josefe17/ClassDAmplifier/schematics-PCB/power_rectifier_board_510/gerbers/IMPORTANT_NOTE.txt

Please, make the board with only solder mask on copper side (gbs file) and silk only on top side (gto file).

Thanks
