josefe17/ClassDAmplifier/schematics-PCB/IRS2092_board_H61M/IRS2092_board_H61M.html

# C:/Users/josefe/Dropbox/etsit/TFG/PCB/IRS2092_board_H61M/IRS2092_board_H61M.sch

19/03/2018 21:16:16

Eeschema 4.0.7

Component Count:94

Ref | Qnty | Value | Part | Datasheet | Description | Vendor
C1, C4, C8, C11, C15, C17 | 6 | 100n | device:C | | Unpolarized capacitor
C2, C3, C9, C10, C14, C20, C26 | 7 | 10u | device:CP | | Polarised capacitor
C5, C6 | 2 | 2n2 | device:C | | Unpolarized capacitor
C7 | 1 | 1n | device:C | | Unpolarized capacitor
C12, C18 | 2 | 1u | device:CP | | Polarised capacitor
C13 | 1 | 22u | device:CP | | Polarised capacitor
C16 | 1 | 47u | device:CP | | Polarised capacitor
C19, C22, C24, C25, C27, C29 | 6 | 100n | device:C | | Unpolarized capacitor
C21, C23 | 2 | 680u | device:CP | | Polarised capacitor
C28 | 1 | 680n | device:C | | Unpolarized capacitor
C30 | 1 | C | device:C | | Unpolarized capacitor
D1, D7, D8 | 3 | 1N4007 | diode:1N4007 | | 50V 1A General Purpose Rectifier Diode, DO-41
D2, D5, D6 | 3 | 18V | device:D_Zener | | Zener Diode
D3 | 1 | MUR120 | ir_audio_mosfets:MUR120
D4 | 1 | BAV21 | diode:BAV21 | | 100V 0.15A standard switching diode, DO-35
J1 | 1 | Vb | conn:Screw_Terminal_01x02 | | Generic screw terminal, single row, 01x02
J2 | 1 | Audio input | IRS2092_board_H61M-cache:CONN_01X02
J3 | 1 | Protection | IRS2092_board_H61M-cache:CONN_01X02
J4 | 1 | Shutdown | IRS2092_board_H61M-cache:CONN_01X02
J5 | 1 | Driver_ON | IRS2092_board_H61M-cache:CONN_01X02
J6 | 1 | Input_test | conn:TEST_1P | | point
J7 | 1 | Output_test | conn:TEST_1P | | point
J8 | 1 | Output | IRS2092_board_H61M-cache:Screw_Terminal_1x02
J9 | 1 | -Vb | conn:Screw_Terminal_01x02 | | Generic screw terminal, single row, 01x02
J10 | 1 | CSD_test | conn:TEST_1P | | point
J11 | 1 | Vss_test | conn:TEST_1P | | point
J12 | 1 | Vaa_test | conn:TEST_1P | | point
J13 | 1 | LO_test | conn:TEST_1P | | point
J14 | 1 | Vcc_test | conn:TEST_1P | | point
J15 | 1 | Vs_test | conn:TEST_1P | | point
L1 | 1 | 47uH | pspice:INDUCTOR
Q1 | 1 | BS250 | device:Q_PMOS_DGS | | Transistor P-MOSFET with substrate diode (general)
Q2, Q3 | 2 | IRFB4020 | ir_audio_mosfets:IRFB4020 | | 200V Vds,18A Id, Single N-Channel Digital Audio HEXFET Power MOSFET, TO-220AB
Q4 | 1 | TIP122 | transistors:TIP122 | | 5A Ic, 60V Vce, Silicon Darlington Power Transistor NPN, TO-220
R1, R10, R14 | 3 | 10R | device:R | | Resistor
R2 | 1 | 330R | device:R | | Resistor
R3 | 1 | 2K | device:R | | Resistor
R4 | 1 | 165R | device:R | | Resistor
R5 | 1 | 2K2 | device:R | | Resistor
R6 | 1 | 3K01 | device:R | | Resistor
R7 | 1 | 6K98 | device:R | | Resistor
R8 | 1 | 1K | device:R | | Resistor
R9 | 1 | 5k11 | device:R | | Resistor
R11, R18 | 2 | 47K | device:R | | Resistor
R12 | 1 | 5K11 | device:R | | Resistor
R13, R23 | 2 | 1K8 | device:R | | Resistor
R15 | 1 | 27K | device:R | | Resistor
R16 | 1 | 4R7 | device:R | | Resistor
R17, R20, R24 | 3 | 10K | device:R | | Resistor
R19 | 1 | 8K06 | device:R | | Resistor
R21, R22 | 2 | 12R | device:R | | Resistor
R25 | 1 | 1R | device:R | | Resistor
R26 | 1 | 10R | device:R | | Resistor
R27 | 1 | 2K2 | device:R | | Resistor
R28 | 1 | R | device:R | | Resistor
RV1 | 1 | 1K | device:POT | | Potentiometer
U1, U4 | 2 | 4N35 | IRS2092_board_H61M-cache:4N35
U2 | 1 | 7905 | IRS2092_board_H61M-cache:7905
U3 | 1 | IRS2092 | ir:IRS2092 | | Protected Class D Audio Amplifier Half-Bridge Gate Driver, With PWM Modulator, Output Current 1.0/1.2A, +/-100V, PDIP-16/SOIC-16
U5 | 1 | 6N136 | IRS2092_board_H61M-rescue:6N136-RESCUE-IRS2092_board_H61M
U6 | 1 | 7805 | IRS2092_board_H61M-cache:7805
U7 | 1 | LM7812 | IRS2092_board_H61M-cache:LM7812
