josefe17/ClassDAmplifier/schematics-PCB/power_rectifier_board_510/power_rectifier_board_510.html

# C:/Users/josefe/Dropbox/etsit/TFG/PCB/power_rectifier_board_510/power_rectifier_board_510.sch

21/03/2018 16:50:49

Eeschema 4.0.7

Component Count:16

Ref | Qnty | Value | Part | Datasheet | Description | Vendor
C1, C2, C3 | 3 | CP | device:CP | | Polarised capacitor
C4 | 1 | CP | device:CP | | Polarised capacitor
C5 | 1 | CP | device:CP | | Polarised capacitor
D1 | 1 | D_Bridge_+A-A | device:D_Bridge_+A-A | | Diode bridge (pins: 1=+, 2=AC, 3=-, 4=AC)
F1 | 1 | Fuse | device:Fuse | | Fuse, generic
J1 | 1 | AC1 in | conn:Screw_Terminal_01x02 | | Generic screw terminal, single row, 01x02
J2 | 1 | AC2 in | conn:Screw_Terminal_01x02 | | Generic screw terminal, single row, 01x02
J3 | 1 | Transf. 1 | conn:Screw_Terminal_01x02 | | Generic screw terminal, single row, 01x02
J4 | 1 | Transf. 2 | conn:Screw_Terminal_01x02 | | Generic screw terminal, single row, 01x02
J5 | 1 | Transf. link | conn:Screw_Terminal_01x02 | | Generic screw terminal, single row, 01x02
J6 | 1 | Transf. out | conn:Screw_Terminal_01x02 | | Generic screw terminal, single row, 01x02
J7 | 1 | Serial link | conn:Screw_Terminal_01x02 | | Generic screw terminal, single row, 01x02
J8 | 1 | DC_A | conn:Screw_Terminal_01x02 | | Generic screw terminal, single row, 01x02
J9 | 1 | DC_B | conn:Screw_Terminal_01x02 | | Generic screw terminal, single row, 01x02
