josefe17/ClassDAmplifier/schematics-PCB/preamplifier_510/preamplifier_510.html

# C:/Users/josefe/Dropbox/etsit/TFG/PCB/preamplifier_510/preamplifier_510.sch

21/03/2018 16:49:08

Eeschema 4.0.7

Component Count:58

Ref | Qnty | Value | Part | Datasheet | Description | Vendor
C1, C8, C9 | 3 | 100u | device:CP | | Polarised capacitor
C3, C6 | 2 | 10u | device:CP_Small | | Polarised capacitor
C4, C7 | 2 | C | device:C | | Unpolarized capacitor
C10, C11, C12, C13 | 4 | 100n | device:C_Small | | Unpolarized capacitor
D1 | 1 | Power | device:LED | | LED generic
D2 | 1 | Parallel/Phase | device:LED | | LED generic
D3 | 1 | Active | device:LED | | LED generic
D4 | 1 | Protection | device:LED | | LED generic
D5 | 1 | -10 | device:LED | | LED generic
D6 | 1 | -5 | device:LED | | LED generic
D7 | 1 | 0 | device:LED | | LED generic
D8 | 1 | 3 | device:LED | | LED generic
D9 | 1 | 6 | device:LED | | LED generic
J1 | 1 | 5Vdc | conn:Conn_01x02 | | Generic connector, single row, 01x02
J2 | 1 | XLR3 | conn:XLR3 | | 3 pins
J4 | 1 | Output Active | conn:Conn_01x02 | | Generic connector, single row, 01x02
J5 | 1 | Protection | conn:Conn_01x02 | | Generic connector, single row, 01x02
J6 | 1 | -Vcc | conn:Conn_01x02 | | Generic connector, single row, 01x02
J7 | 1 | +Vcc | conn:Conn_01x02 | | Generic connector, single row, 01x02
J8 | 1 | Out_A(A)/Dir_B(B) | conn:Conn_01x02 | | Generic connector, single row, 01x02
J9 | 1 | Dir_B(A)/B_in(B) | conn:Conn_01x02 | | Generic connector, single row, 01x02
J10 | 1 | B_in(A)/Out_B(B) | conn:Conn_01x02 | | Generic connector, single row, 01x02
J11 | 1 | VU_level | conn:TEST_1P | | point
J12 | 1 | Preamp_out | conn:TEST_1P | | point
JP1 | 1 | FIXED-GAIN | device:Jumper_NC_Dual | | Dual Jumper, normally closed
JP2 | 1 | Out_A(A)/φ(B) | device:Jumper_NC_Dual | | Dual Jumper, normally closed
Q1 | 1 | BC547 | transistors:BC547 | | 45V Vce, 0.1A Ic, NPN, Small Signal Transistor, TO-92
R1, R2 | 2 | 220R | device:R | | Resistor
R3, R4, R6, R7, R15, R16 | 6 | 10K | device:R | | Resistor
R5 | 1 | 82R5 | device:R | | Resistor
R8 | 1 | 0R | device:R | | Resistor
R9 | 1 | 1K1 | device:R | | Resistor
R10 | 1 | 2K2 | device:R | | Resistor
R11 | 1 | R | device:R | | Resistor
R12 | 1 | 3K3 | device:R | | Resistor
R13 | 1 | 6K8 | device:R | | Resistor
R14 | 1 | Rled | device:R | | Resistor
R17 | 1 | Rf | device:R | | Resistor
RV1 | 1 | VOLUME | device:POT_Dual_Separate | | Dual Potentiometer, separate units
RV2 | 1 | 10K | device:POT | | Potentiometer
SW1 | 1 | Parallel/Phase | switches:SW_DPDT_x2 | | Switch, dual pole double throw, separate symbols
SW2 | 1 | +4/-10 | switches:SW_DPDT_x2 | | Switch, dual pole double throw, separate symbols
U1 | 1 | TL072 | linear:TL072 | | Dual Operational Amplifiers, DIP-8/SOIC-8/TSSOP-8/VSSOP-8
U2 | 1 | AN6884 | an6884:AN6884 | | AN6884 Audio meter VU scale
U3 | 1 | TL071 | linear:TL071 | | Operational Amplifier, DIP-8/TO-99-8
