josefe17/ClassDAmplifier/schematics-PCB/regulated_power_supply_510/regulated_power_supply_510.html

# C:/Users/josefe/Dropbox/etsit/TFG/PCB/regulated_power_supply_510/regulated_power_supply_510.sch

21/03/2018 16:51:49

Eeschema 4.0.7

Component Count:20

Ref | Qnty | Value | Part | Datasheet | Description | Vendor
C1, C4 | 2 | 100nF | device:C | | Unpolarized capacitor
C2 | 1 | 2200uf | device:CP | | Polarised capacitor
C3 | 1 | 10uF | device:CP | | Polarised capacitor
C5 | 1 | 1000uF | device:CP | | Polarised capacitor
D1 | 1 | VS-KBPC110 | device:D_Bridge_-A+A | | Diode bridge (pins: 1=-, 2=AC, 3=+, 4=AC)
D2, D3 | 2 | 1N4007 | device:D | | Diode
F1 | 1 | 200mA | device:Fuse | | Fuse, generic
J1 | 1 | AC in | conn:Screw_Terminal_01x02 | | Generic screw terminal, single row, 01x02
J2 | 1 | DC link | conn:Conn_01x02 | | Generic connector, single row, 01x02
J3 | 1 | DC1 | conn:Conn_01x02 | | Generic connector, single row, 01x02
J4 | 1 | DC2 | conn:Conn_01x02 | | Generic connector, single row, 01x02
J5 | 1 | DC3 | conn:Conn_01x02 | | Generic connector, single row, 01x02
J6 | 1 | GND | conn:Conn_01x02 | | Generic connector, single row, 01x02
J7 | 1 | unregulated DC | conn:Conn_01x02 | | Generic connector, single row, 01x02
R1 | 1 | 240R | device:R | | Resistor
RV1 | 1 | 2K | device:POT | | Potentiometer
U1 | 1 | LM317 | regul:LM317_3PinPackage | | 1A 35V Adjustable Linear Regulator, SOT-89/SOT-223/TO-220/TO-252/TO-263
U2 | 1 | LM337 | regul:LM337_TO220 | | Negative 1.5A 35V Adjustable Linear Regulator, TO-220
