josefe17/ClassDAmplifier/Block_diagrams/blocks_POWER.PNG

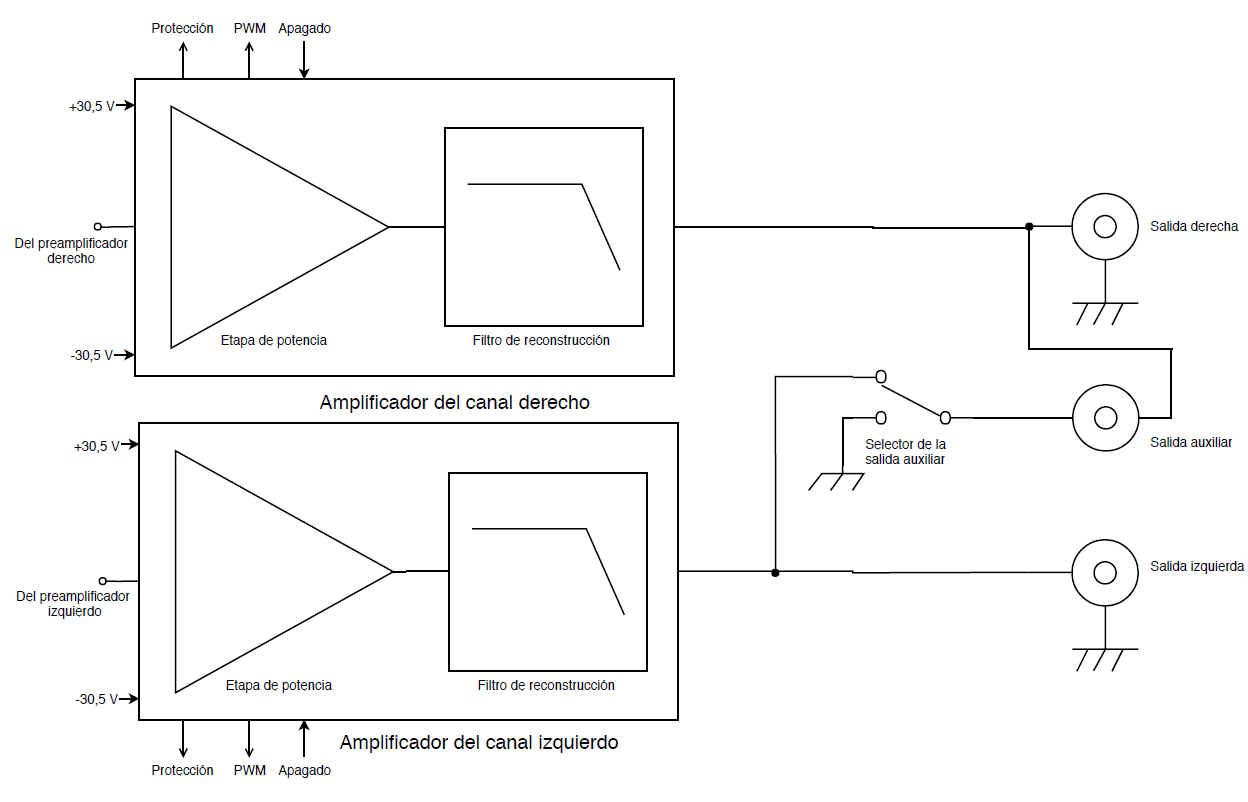
Block_diagrams/blocks_POWER.PNG
