josefe17/ClassDAmplifier/Block_diagrams/blocks_PREAMP.PNG

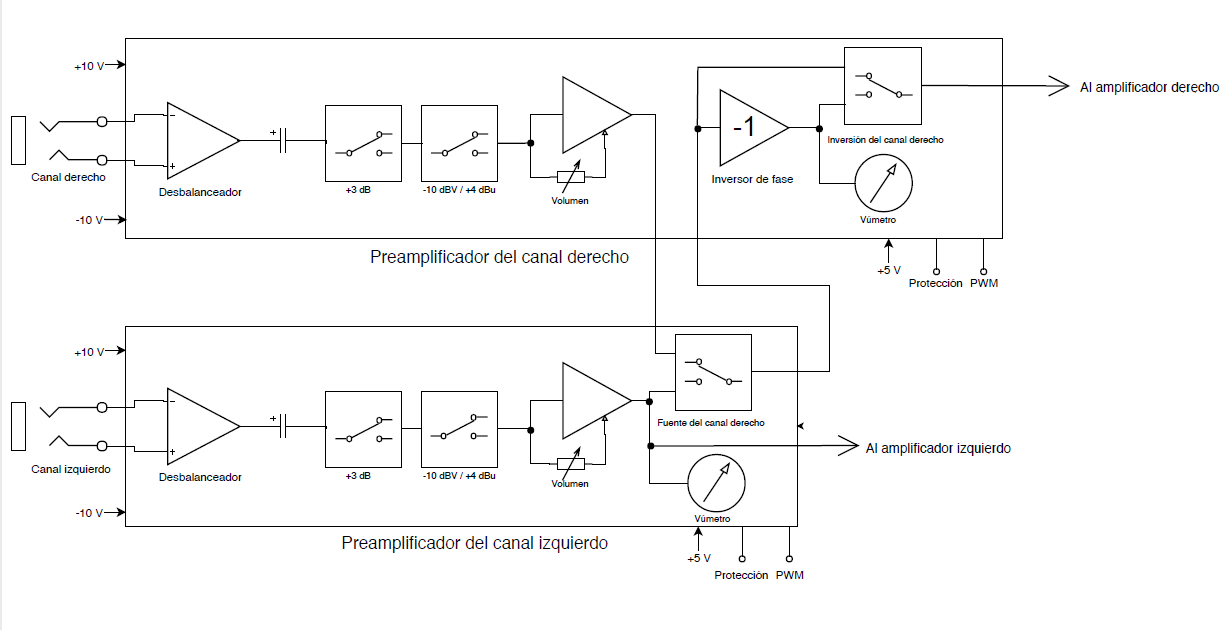
Block_diagrams/blocks_PREAMP.PNG
