josefe17/ClassDAmplifier/Block_diagrams/blocks_PSU.PNG

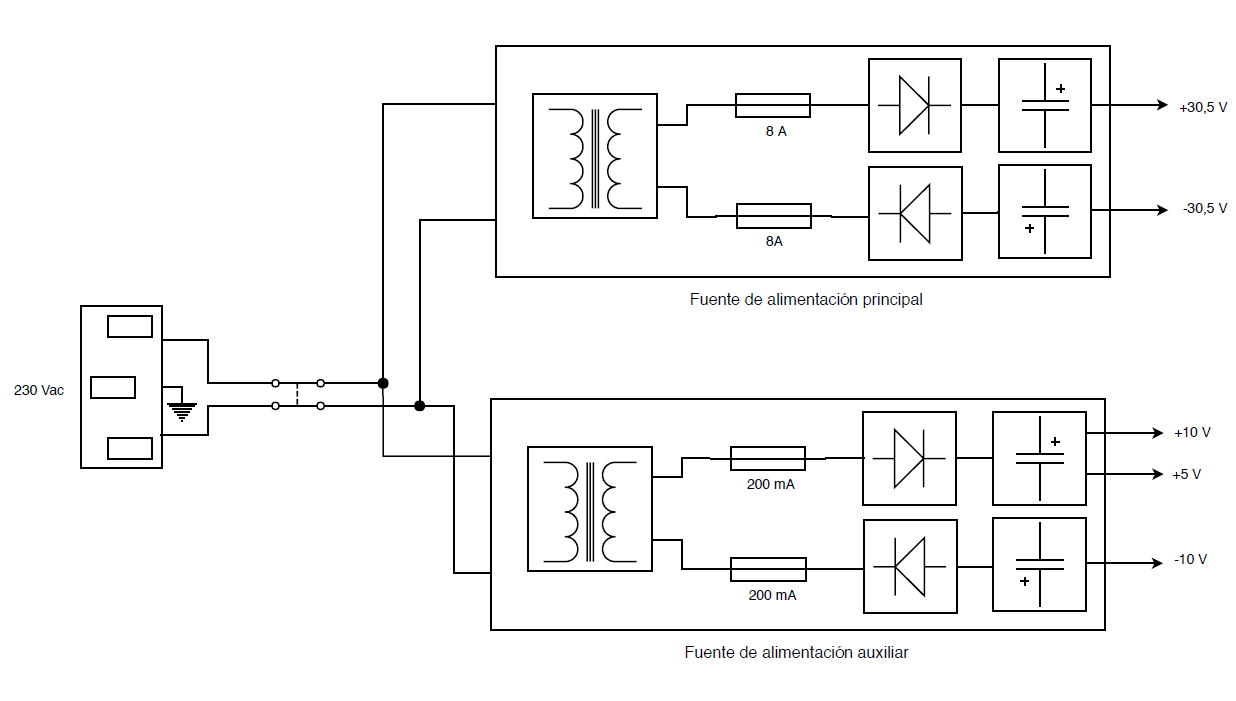
Block_diagrams/blocks_PSU.PNG
