josefe17/ClassDAmplifier/Block_diagrams/blocks_selector.PNG

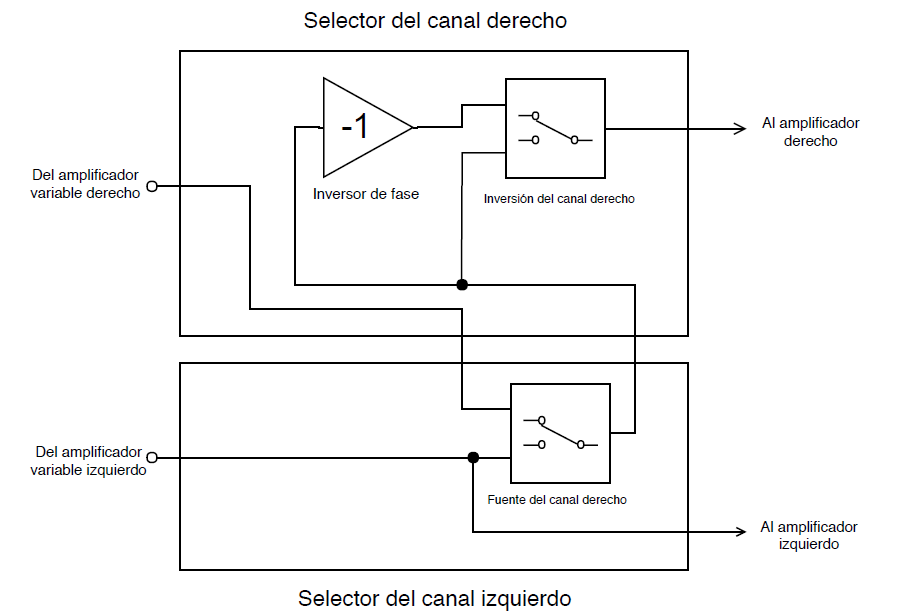
Block_diagrams/blocks_selector.PNG
