josefe17/ClassDAmplifier/Pictures/device_pic_3.JPG

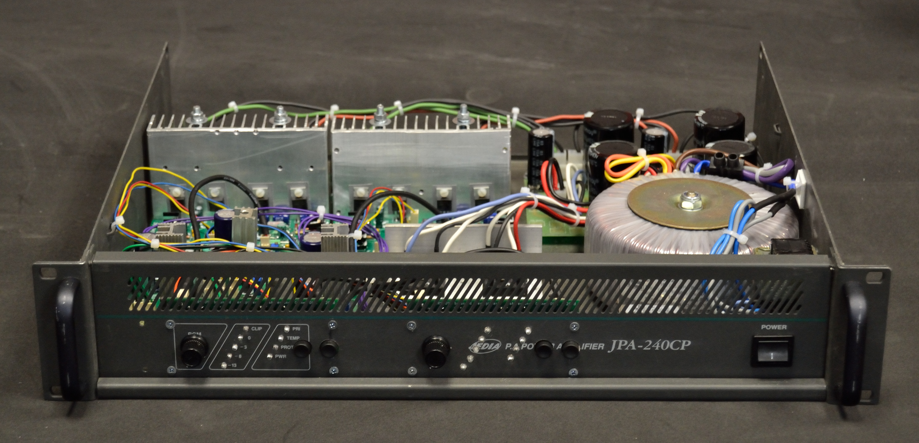
Pictures/device_pic_3.JPG
