josefe17/ClassDAmplifier/Pictures/front_pic_3.JPG

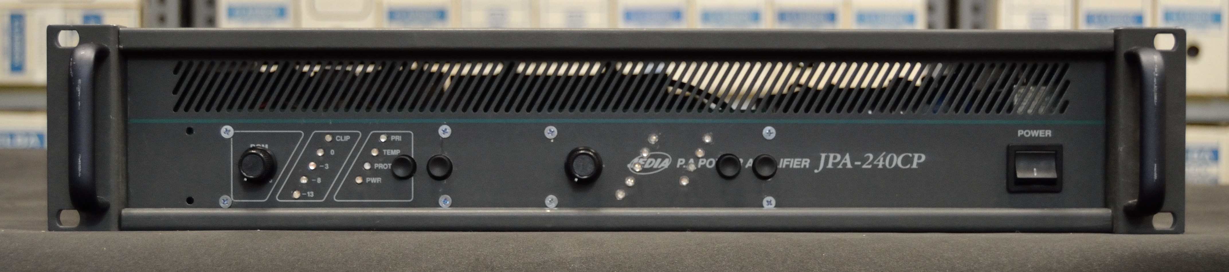
Pictures/front_pic_3.JPG
