josefe17/ClassDAmplifier/Pictures/proto_v0.jpg

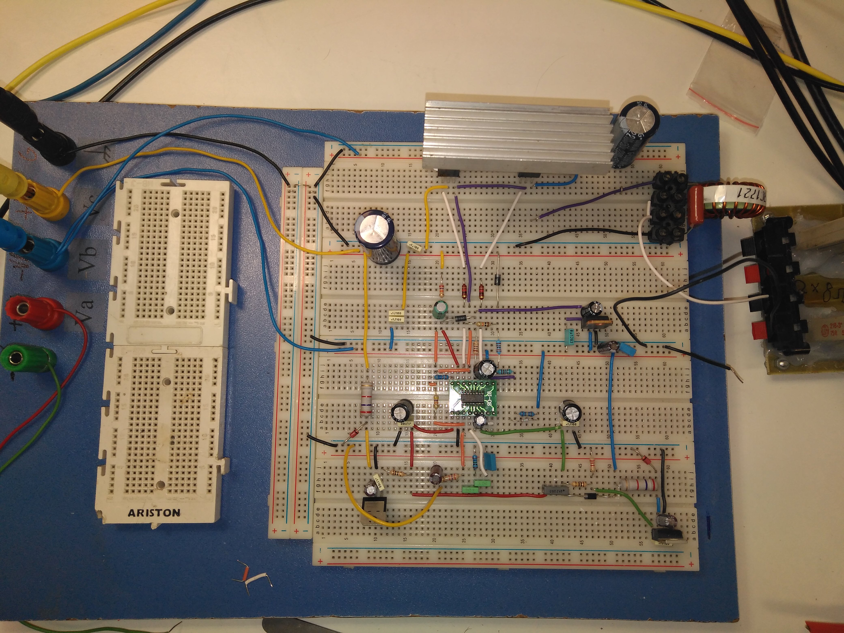
Pictures/proto_v0.jpg
