josefe17/ClassDAmplifier/Pictures/proto_v1.jpg

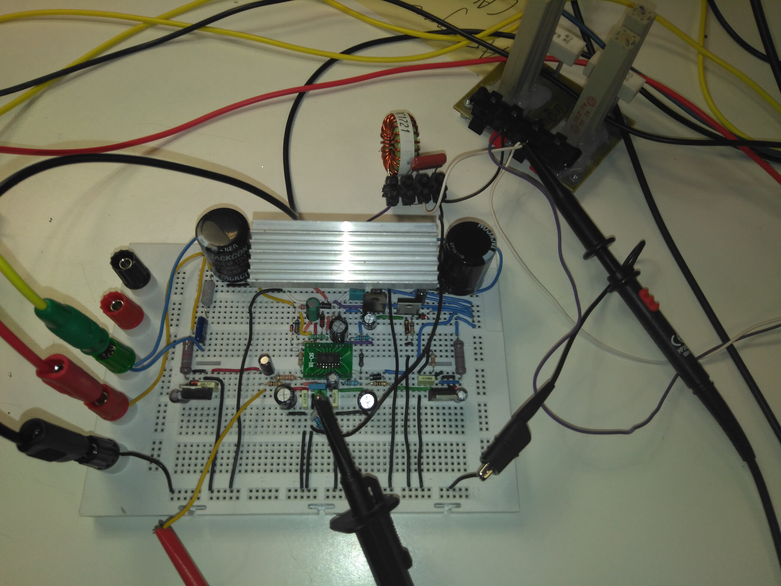
Pictures/proto_v1.jpg
