josefe17/ClassDAmplifier/Pictures/top_pic.JPG

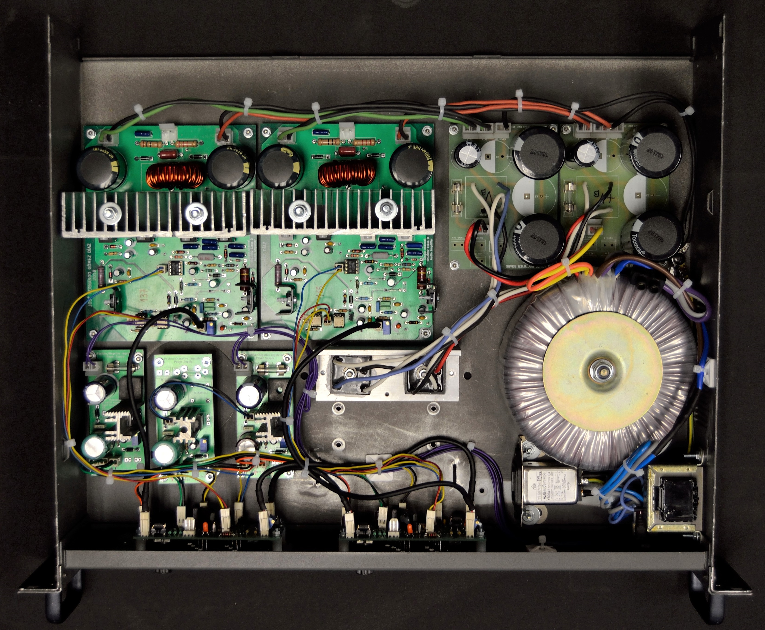
Pictures/top_pic.JPG
