josefe17/ClassDAmplifier/schematics-PCB/IRS2092_board_H61M/3d/IRS2092_board_H61M_v3_angled.png

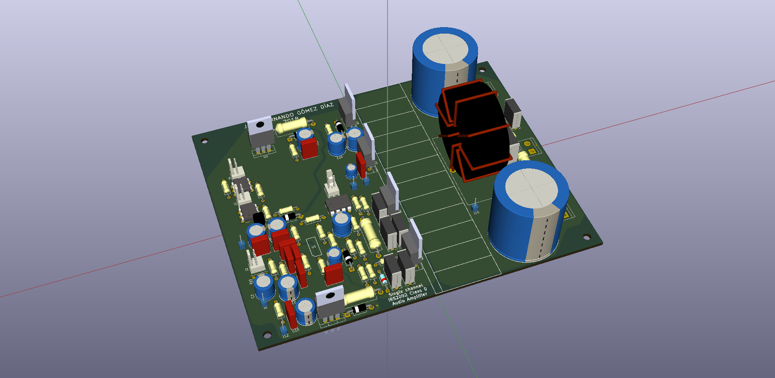
schematics-PCB/IRS2092_board_H61M/3d/IRS2092_board_H61M_v3_angled.png
