josefe17/ClassDAmplifier/schematics-PCB/IRS2092_board_H61M/IRS2092_board_H61M.png

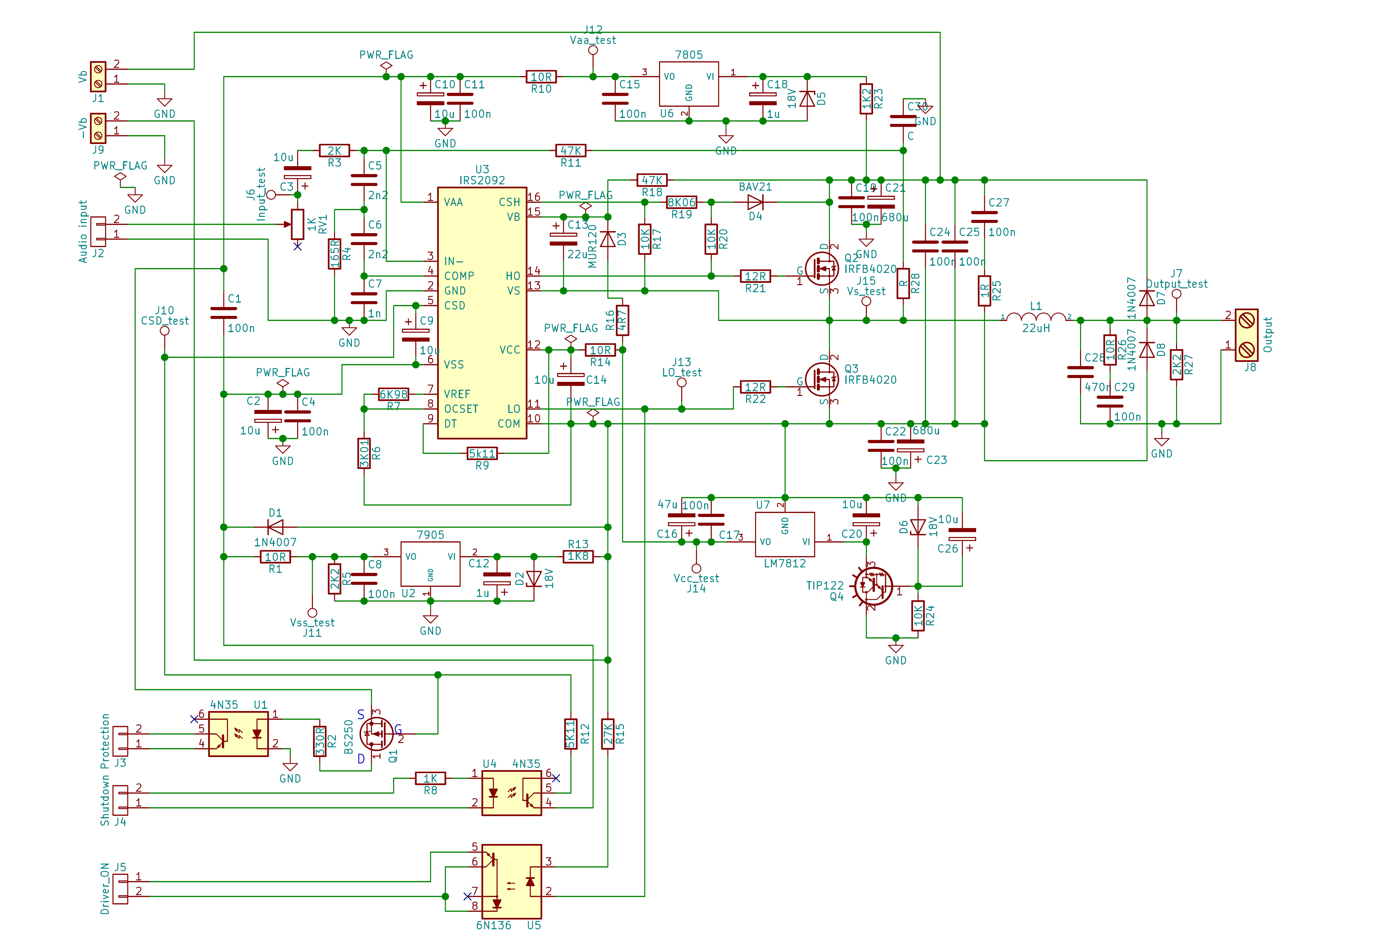
schematics-PCB/IRS2092_board_H61M/IRS2092_board_H61M.png
