josefe17/ClassDAmplifier/schematics-PCB/power_rectifier_board_510/3d/power_rectifier_board_510_naked.png

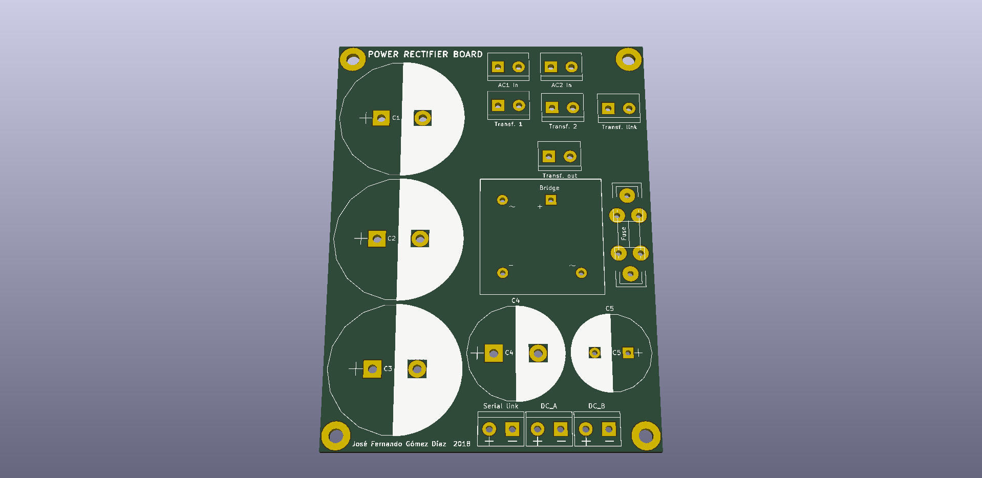
schematics-PCB/power_rectifier_board_510/3d/power_rectifier_board_510_naked.png
