josefe17/ClassDAmplifier/schematics-PCB/power_rectifier_board_510/power_rectifier_board_510.png

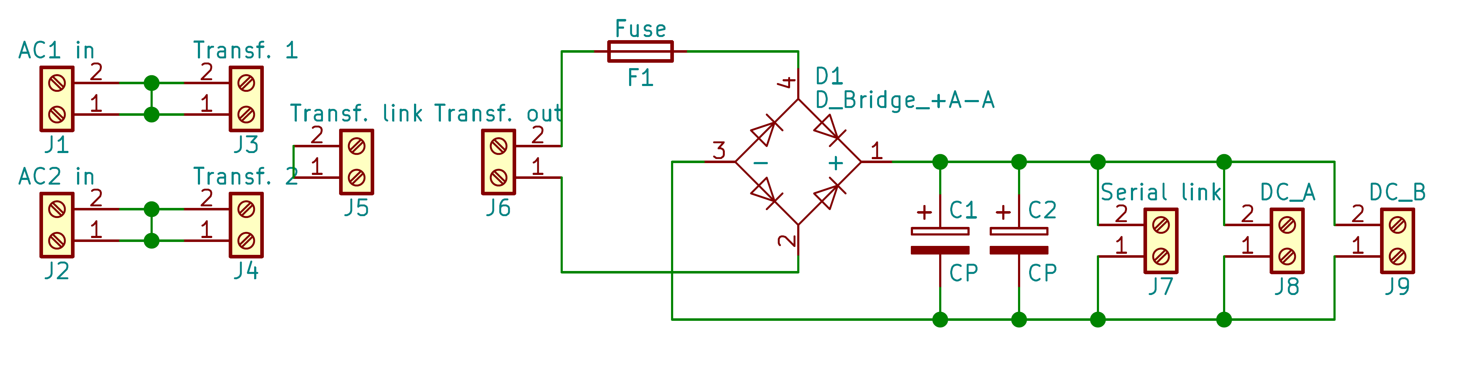
schematics-PCB/power_rectifier_board_510/power_rectifier_board_510.png
