josefe17/ClassDAmplifier/schematics-PCB/preamplifier_510/3d/preamplifier_510_back_naked.png

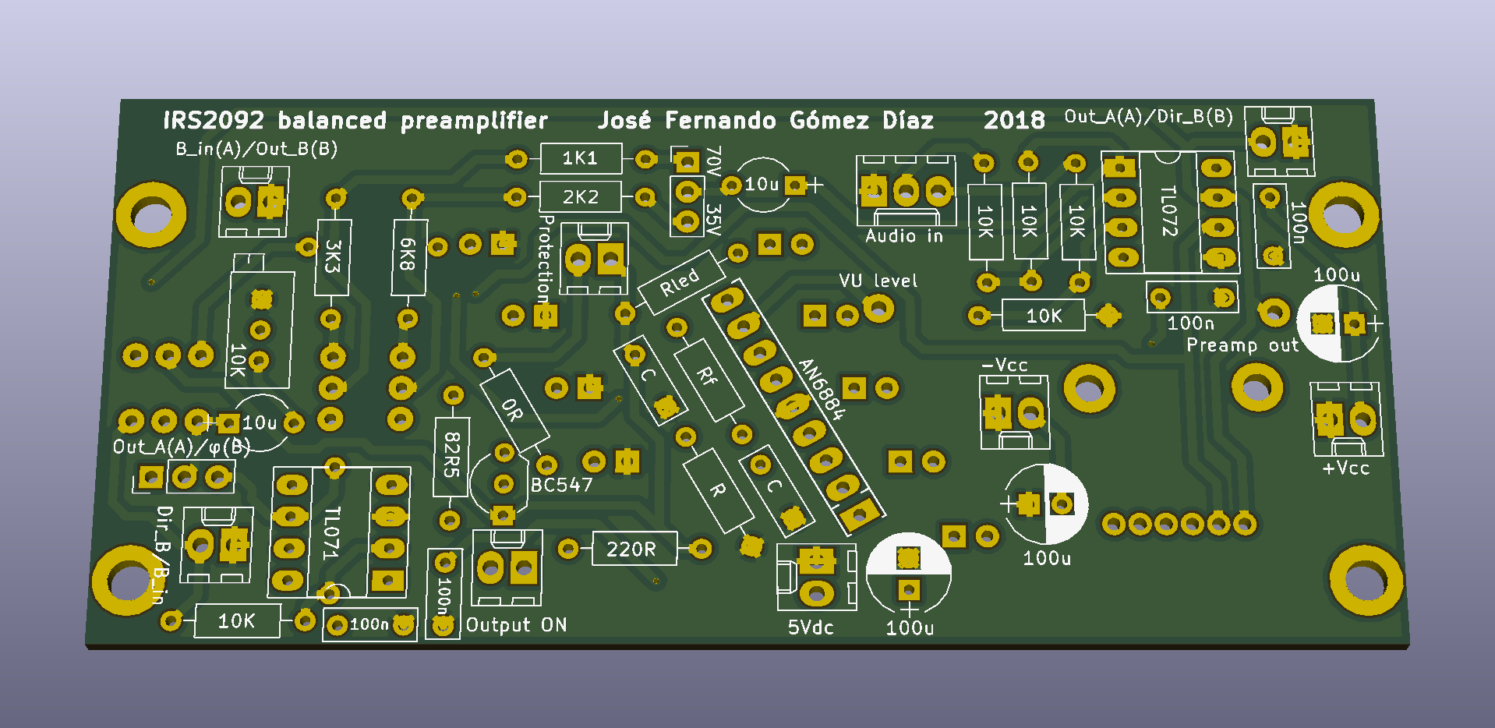
schematics-PCB/preamplifier_510/3d/preamplifier_510_back_naked.png
