josefe17/ClassDAmplifier/schematics-PCB/preamplifier_510/3d/preamplifier_510_front.png

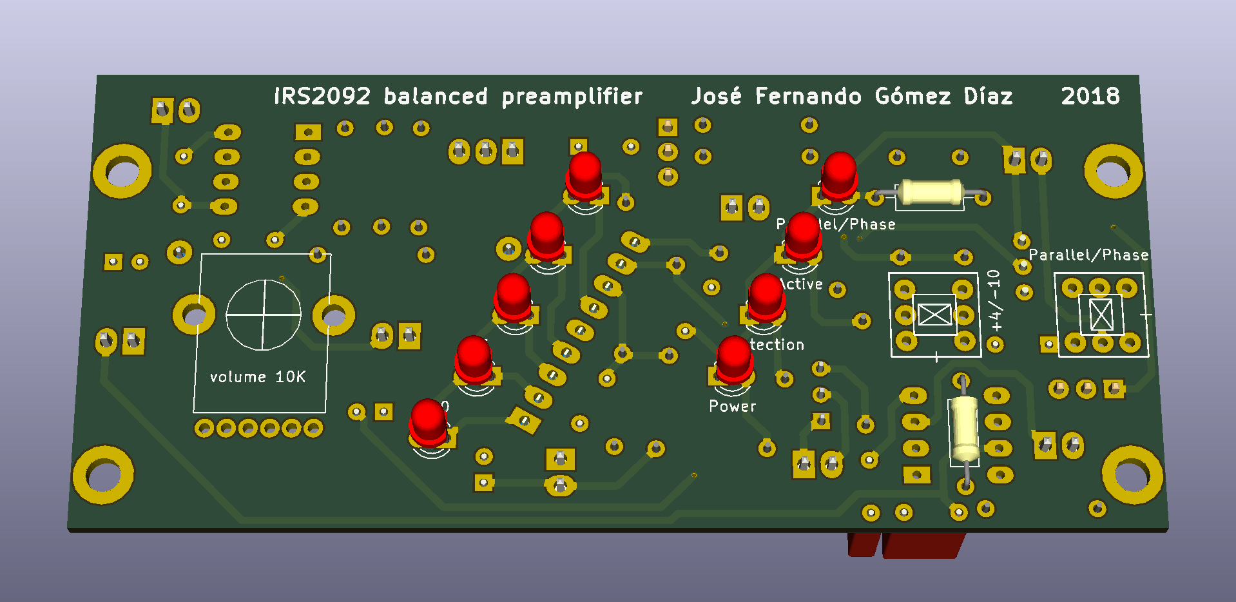
schematics-PCB/preamplifier_510/3d/preamplifier_510_front.png
