josefe17/ClassDAmplifier/schematics-PCB/preamplifier_510/3d/preamplifier_510_front_naked.png

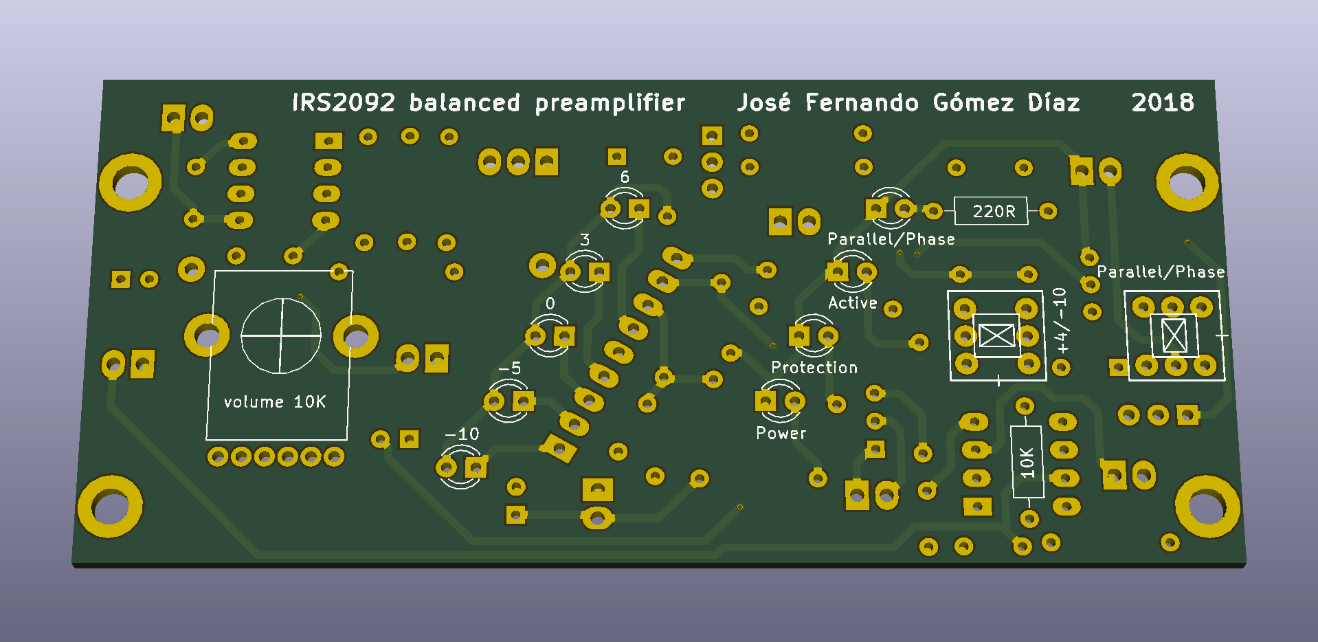
schematics-PCB/preamplifier_510/3d/preamplifier_510_front_naked.png
