josefe17/ClassDAmplifier/schematics-PCB/preamplifier_510/preamplifier.PNG

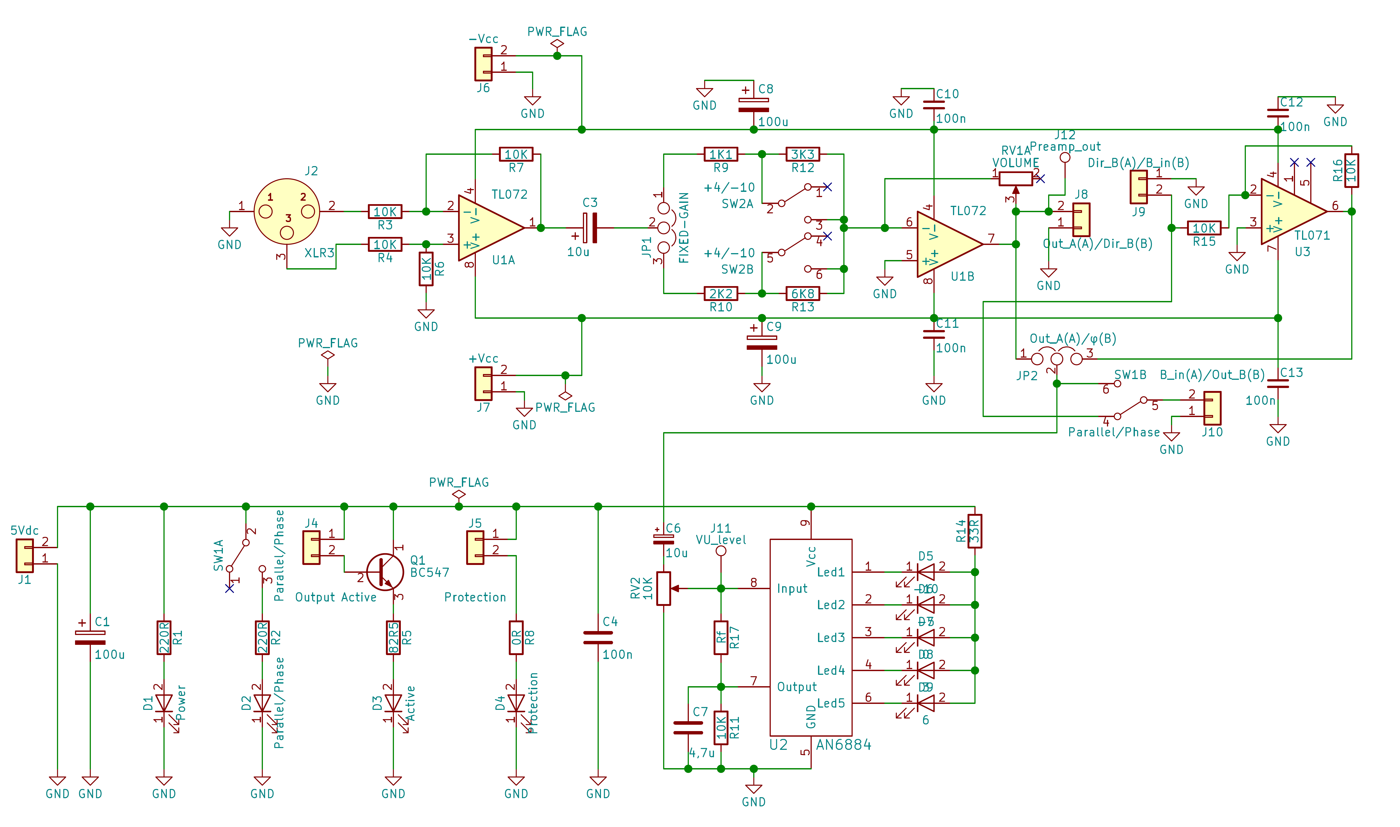
schematics-PCB/preamplifier_510/preamplifier.PNG
