josefe17/ClassDAmplifier/schematics-PCB/regulated_power_supply_510/regulated_power_supply_510.png

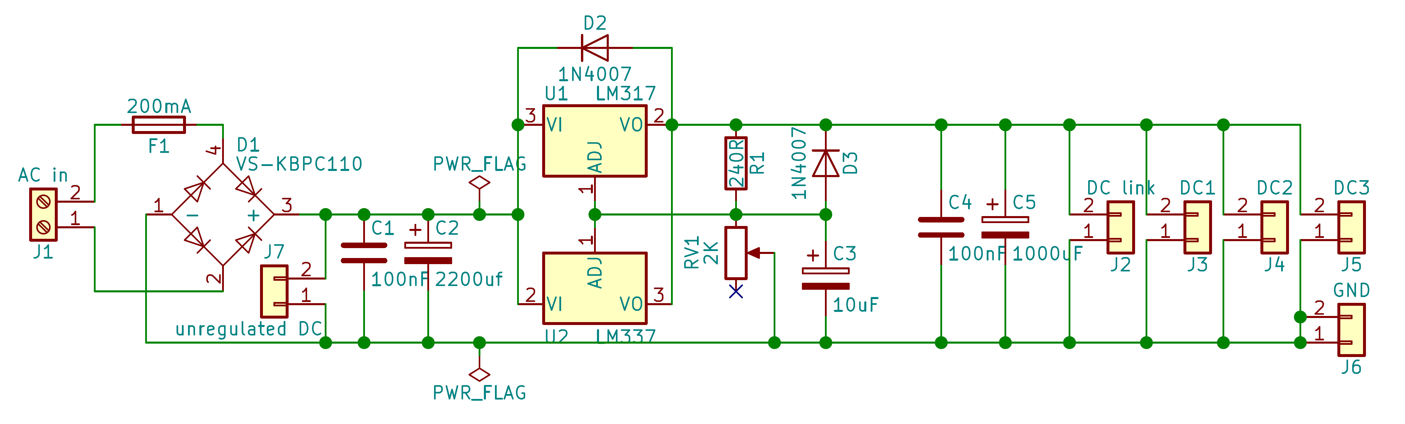
schematics-PCB/regulated_power_supply_510/regulated_power_supply_510.png
