josefe17/ClassDAmplifier/Measurements/Graphs/4ohm_together.png

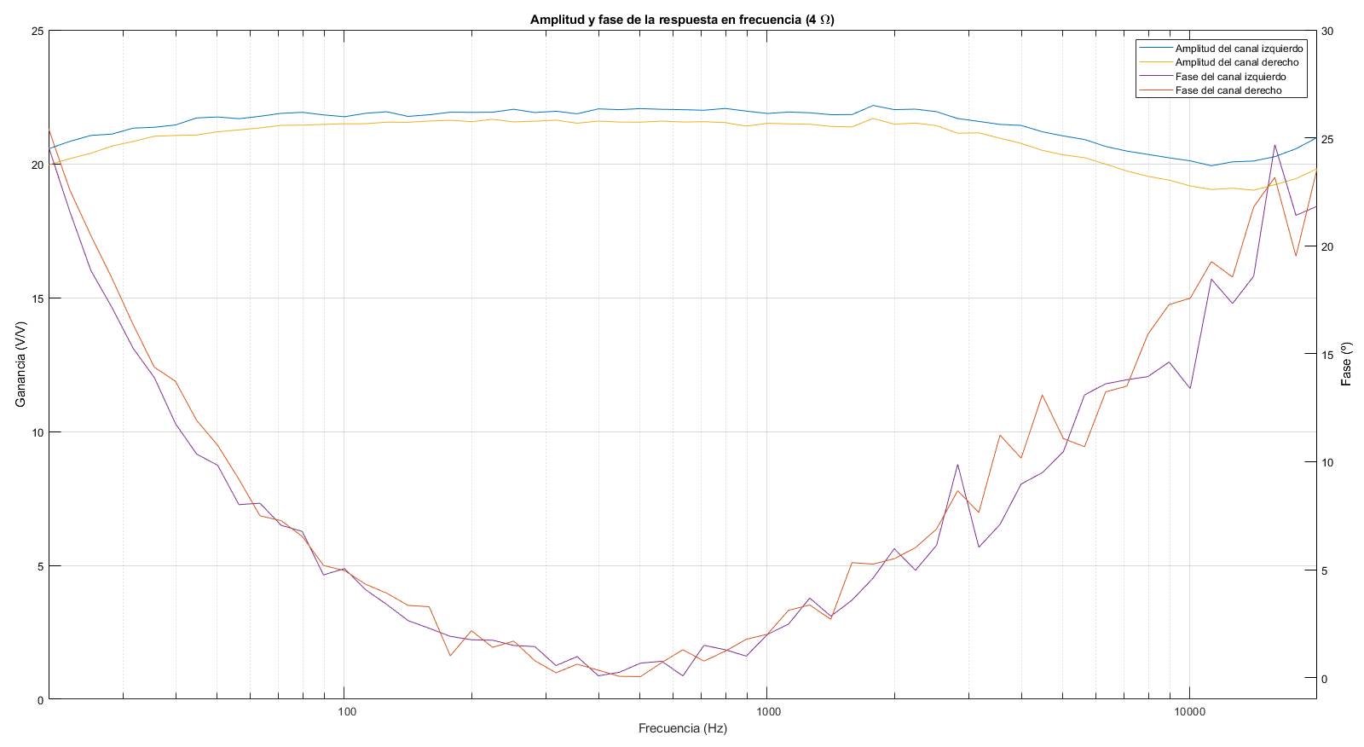
Measurements/Graphs/4ohm_together.png
