josefe17/ClassDAmplifier/Measurements/Graphs/4ohm_together_bigsize.png

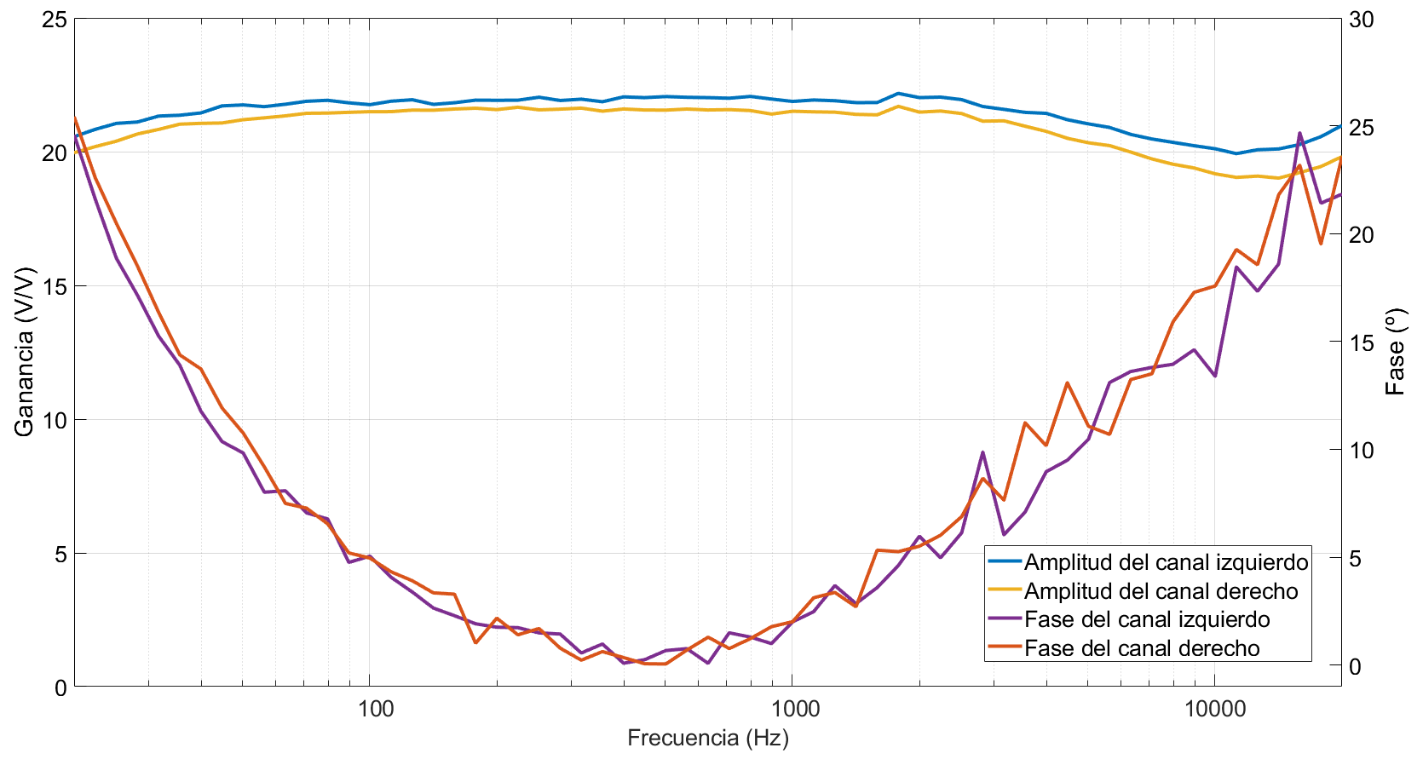
Measurements/Graphs/4ohm_together_bigsize.png
