josefe17/ClassDAmplifier/Measurements/Graphs/8ohm_bridge_together.png

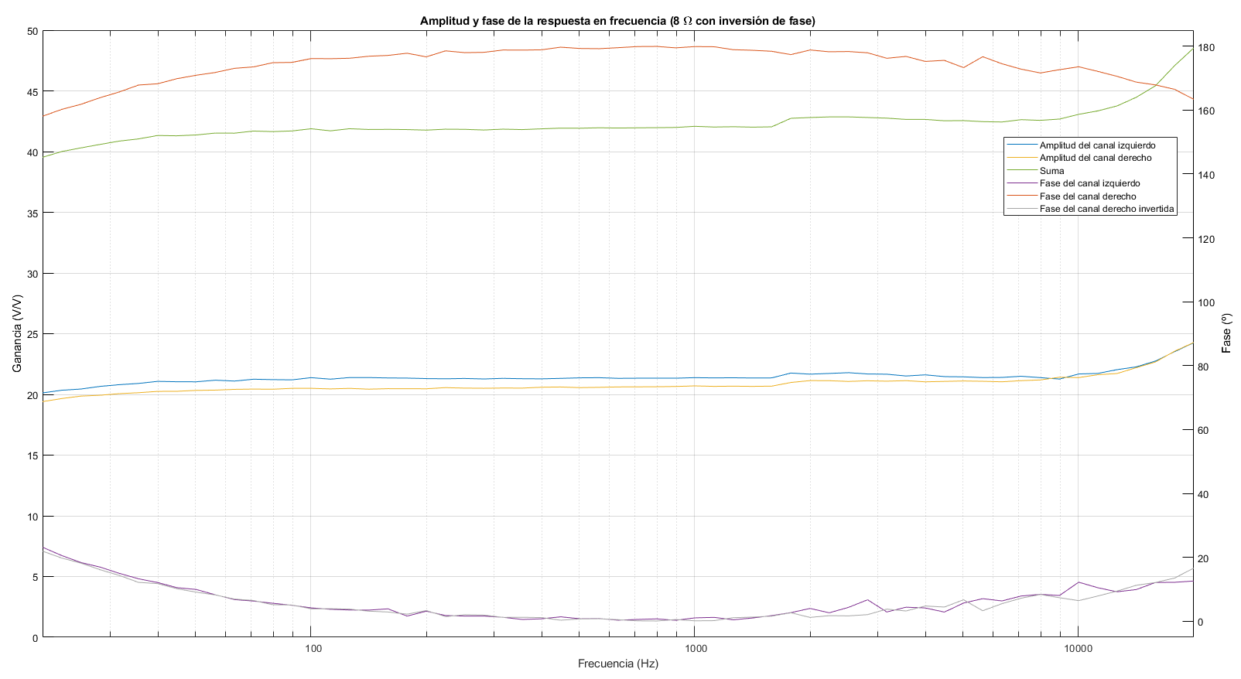
Measurements/Graphs/8ohm_bridge_together.png
