josefe17/ClassDAmplifier/Measurements/Graphs/8ohm_bridge_together_bigsize.png

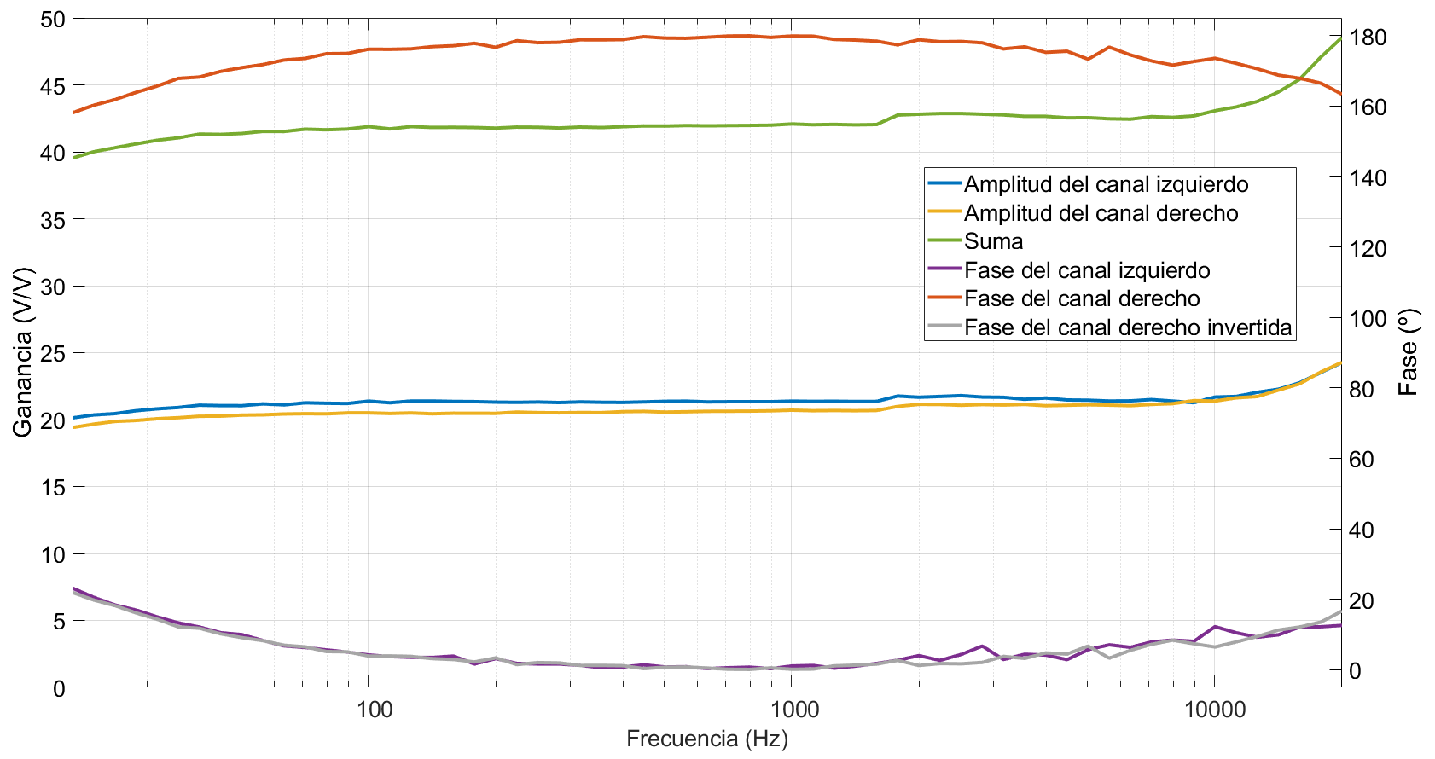
Measurements/Graphs/8ohm_bridge_together_bigsize.png
