josefe17/ClassDAmplifier/Measurements/Graphs/8ohm_together.png

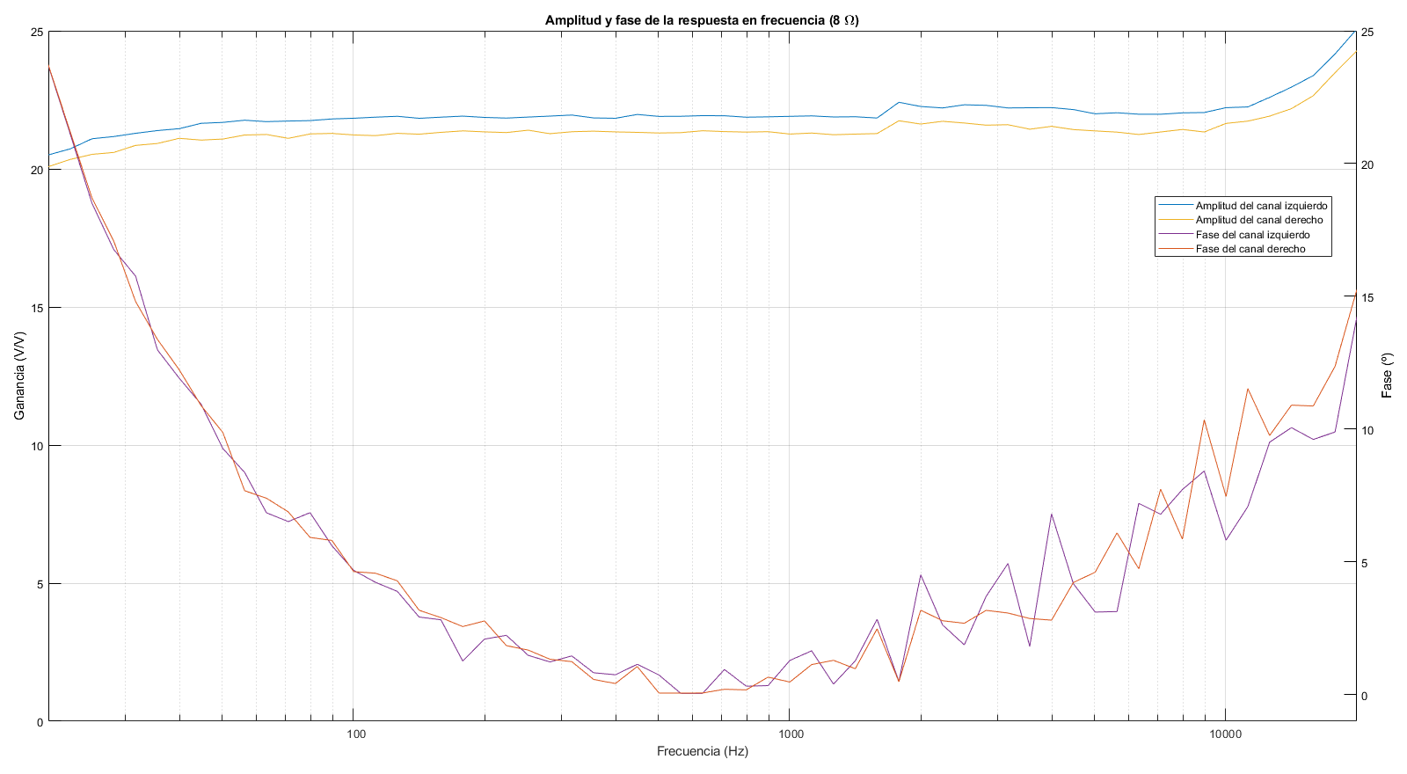
Measurements/Graphs/8ohm_together.png
