josefe17/ClassDAmplifier/Measurements/Graphs/8ohm_together_bigsize.png

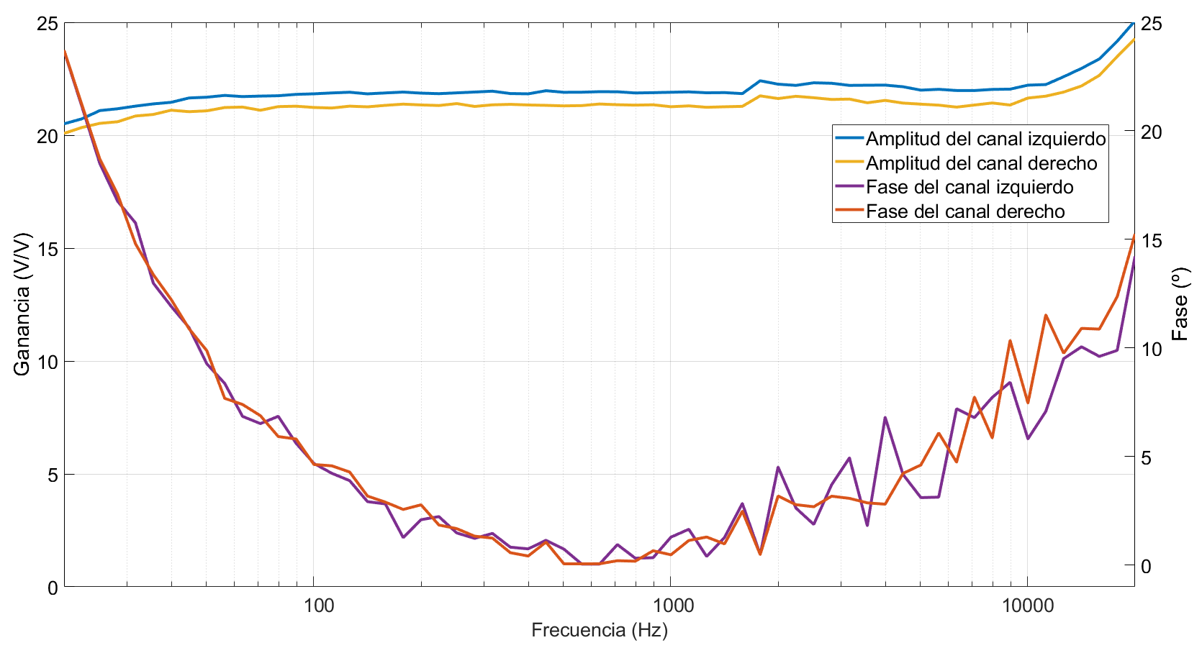
Measurements/Graphs/8ohm_together_bigsize.png
