josefe17/ClassDAmplifier/schematics-PCB/IRS2092_board_H61M/IRS2092_board_H61M.pdf

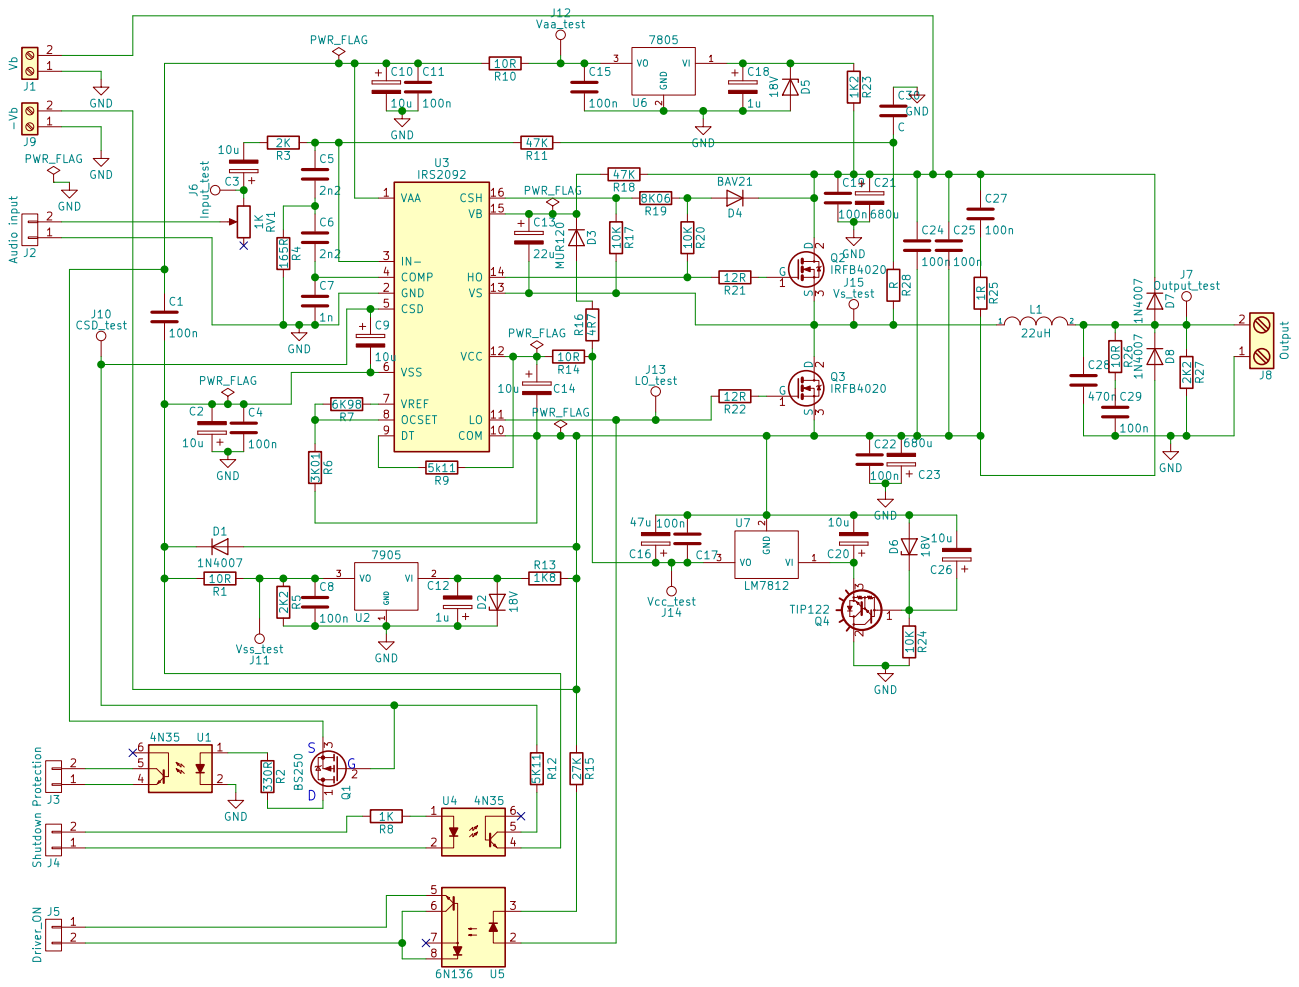
[picture p33: page 1]
