josefe17/ClassDAmplifier/schematics-PCB/power_rectifier_board_510/power_rectifier_board_510.pdf

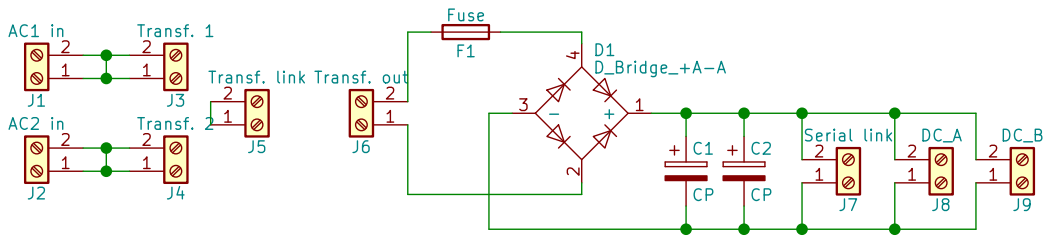
[picture p34: page 1]
