josefe17/ClassDAmplifier/schematics-PCB/preamplifier_510/preamplifier_510.pdf

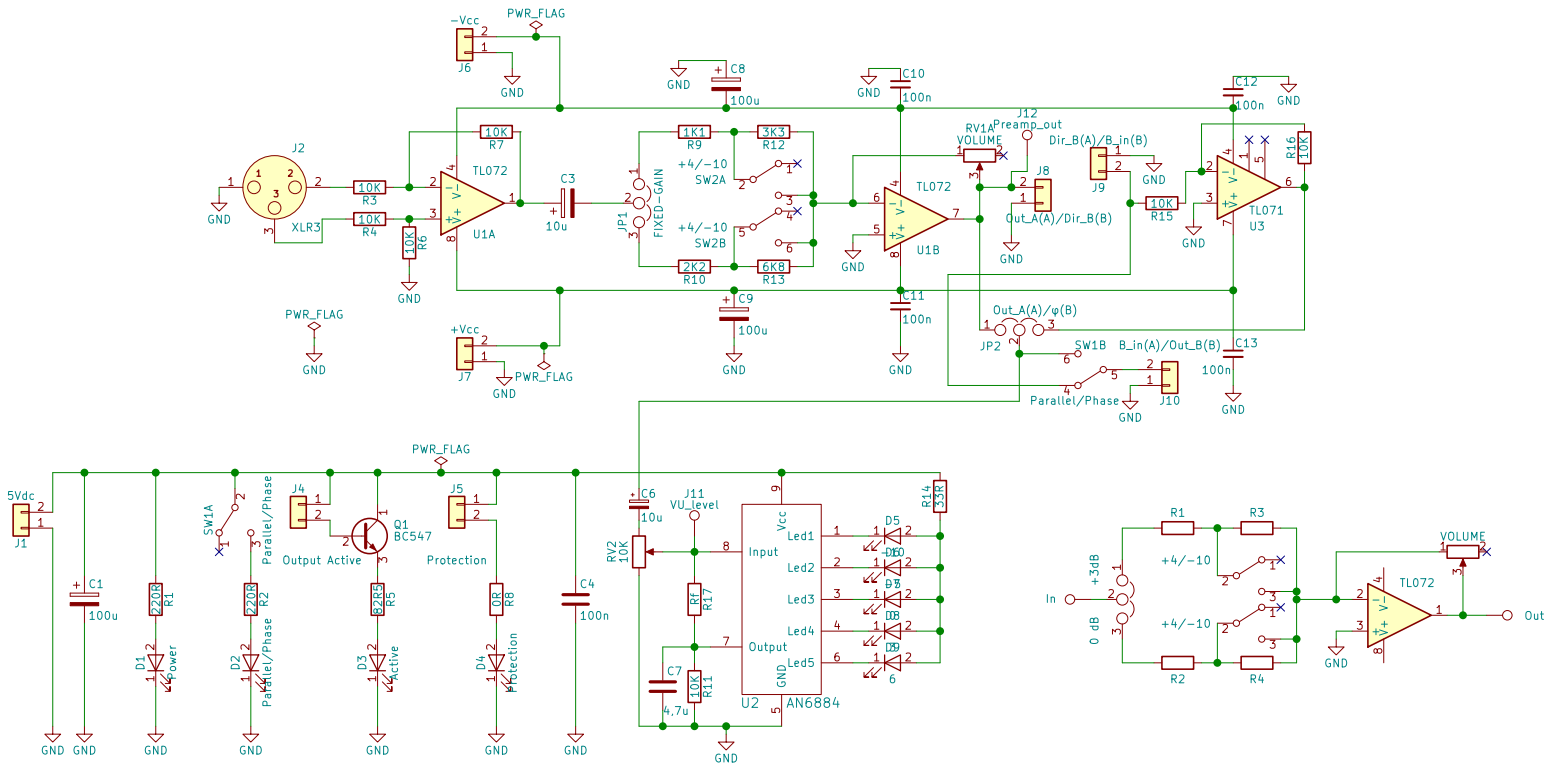
[picture p35: page 1]
