josefe17/ClassDAmplifier/schematics-PCB/regulated_power_supply_510/regulated_power_supply_510.pdf

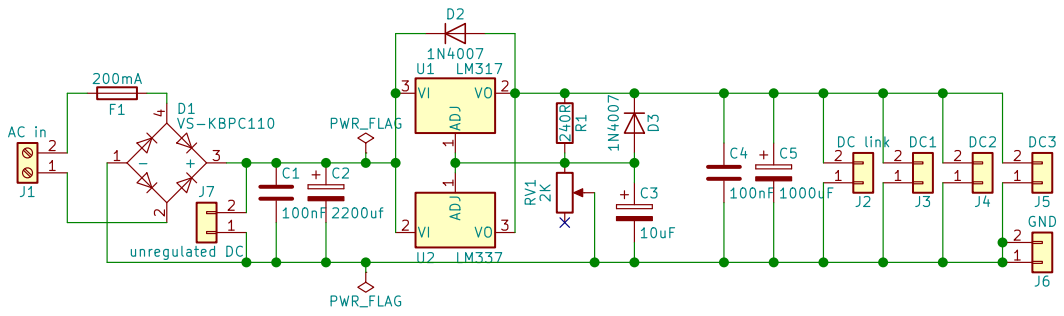
[picture p36: page 1]
