josefe17/ClassDAmplifier/schematics-PCB/IRS2092_board_H61M/IRS2092_board_H61M.kicad_pcb

## KiCad design schematics-PCB/IRS2092_board_H61M/IRS2092_board_H61M.kicad_pcb (2018-05-30)

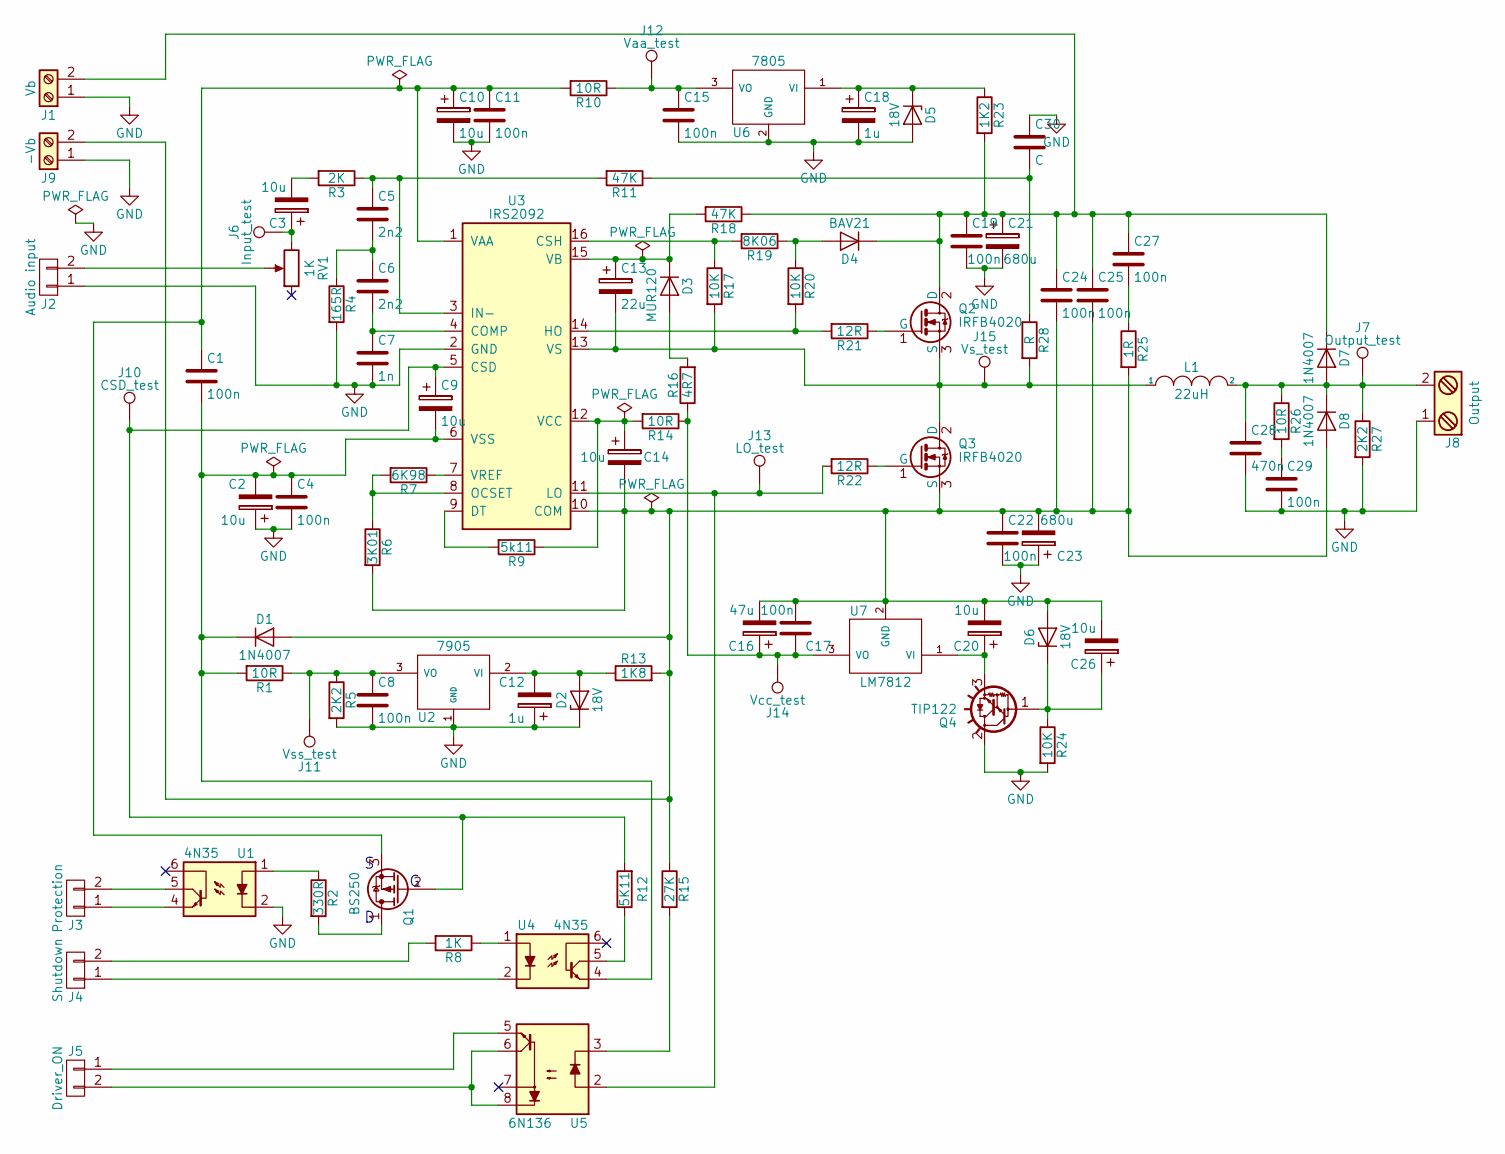
[picture p37: schematic IRS2092_board_H61M.sch, IRS20192 power board]

Parts:
C1, C4, C8, C11, C15, C17: 100n; C_Rect_L7.0mm_W2.5mm_P5.00mm
C2, C3, C9, C10, C14, C20, C26: 10u; CP_Radial_D8.0mm_P2.50mm
C5, C6: 2n2; C_Rect_L7.0mm_W2.5mm_P5.00mm
C7: 1n; C_Rect_L7.0mm_W2.5mm_P5.00mm
C12, C18: 1u; CP_Radial_D8.0mm_P2.50mm
C13: 22u; CP_Radial_D6.3mm_P2.50mm
C16: 47u; CP_Radial_D5.0mm_P2.00mm
C19, C22, C24, C25, C27, C29: 100n; C_Rect_L11.5mm_W4.0mm_P10.00mm_MKT
C21, C23: 680u; CP_Radial_D30.0mm_P10.00mm_SnapIn
C28: 470n; C_Rect_L16.5mm_W8.9mm_P15.00mm_MKT
C30: C; C_Rect_L7.0mm_W2.5mm_P5.00mm
D1, D7, D8: 1N4007; D_DO-41_SOD81_P10.16mm_Horizontal
D2, D5, D6: 18V; D_DO-41_SOD81_P10.16mm_Horizontal
D3: MUR120; D_DO-41_SOD81_P10.16mm_Horizontal
D4: BAV21; D_DO-35_SOD27_P10.16mm_Horizontal
J1: Vb; TerminalBlock_bornier-2_P5.08mm
J2: Audio input; Molex_KK-6410-02_02x2.54mm_Straight
J3: Protection; Molex_KK-6410-02_02x2.54mm_Straight
J4: Shutdown; Molex_KK-6410-02_02x2.54mm_Straight
J5: Driver_ON; Molex_KK-6410-02_02x2.54mm_Straight
J6: Input_test; PINTST
J7: Output_test; PINTST
J8: Output; TerminalBlock_bornier-2_P5.08mm
J9: -Vb; TerminalBlock_bornier-2_P5.08mm
J10: CSD_test; PINTST
J11: Vss_test; PINTST
J12: Vaa_test; PINTST
J13: LO_test; PINTST
J14: Vcc_test; PINTST
J15: Vs_test; PINTST
L1: 22uH; L_Toroid_Vertical_L41.9mm_W19.1mm_P15.80mm_Vishay_TJ7
Q1: BS250; TO-92_Inline_Narrow_Oval
Q2, Q3: IRFB4020; TO-220-3_Vertical
Q4: TIP122; TO-220-3_Vertical
R1, R10, R14: 10R; R_Axial_DIN0207_L6.3mm_D2.5mm_P10.16mm_Horizontal
R2: 330R; R_Axial_DIN0207_L6.3mm_D2.5mm_P10.16mm_Horizontal
R3: 2K; R_Axial_DIN0207_L6.3mm_D2.5mm_P10.16mm_Horizontal
R4: 165R; R_Axial_DIN0207_L6.3mm_D2.5mm_P10.16mm_Horizontal
R5: 2K2; R_Axial_DIN0207_L6.3mm_D2.5mm_P10.16mm_Horizontal
R6: 3K01; R_Axial_DIN0207_L6.3mm_D2.5mm_P10.16mm_Horizontal
R7: 6K98; R_Axial_DIN0207_L6.3mm_D2.5mm_P10.16mm_Horizontal
R8: 1K; R_Axial_DIN0207_L6.3mm_D2.5mm_P10.16mm_Horizontal
R9: 5k11; R_Axial_DIN0207_L6.3mm_D2.5mm_P10.16mm_Horizontal
R11, R18: 47K; R_Axial_DIN0207_L6.3mm_D2.5mm_P10.16mm_Horizontal
R12: 5K11; R_Axial_DIN0207_L6.3mm_D2.5mm_P10.16mm_Horizontal
R13: 1K8; R_Axial_DIN0516_L15.5mm_D5.0mm_P20.32mm_Horizontal
R15: 27K; R_Axial_DIN0207_L6.3mm_D2.5mm_P10.16mm_Horizontal
R16: 4R7; R_Axial_DIN0207_L6.3mm_D2.5mm_P10.16mm_Horizontal
R17, R20, R24: 10K; R_Axial_DIN0207_L6.3mm_D2.5mm_P10.16mm_Horizontal
R19: 8K06; R_Axial_DIN0207_L6.3mm_D2.5mm_P10.16mm_Horizontal
R21, R22: 12R; R_Axial_DIN0207_L6.3mm_D2.5mm_P10.16mm_Horizontal
R23: 1K2; R_Axial_DIN0516_L15.5mm_D5.0mm_P20.32mm_Horizontal
R25: 1R; R_Axial_DIN0516_L15.5mm_D5.0mm_P20.32mm_Horizontal
R26: 10R; R_Axial_DIN0516_L15.5mm_D5.0mm_P20.32mm_Horizontal
R27: 2K2; R_Axial_DIN0516_L15.5mm_D5.0mm_P20.32mm_Horizontal
R28: R; R_Axial_DIN0207_L6.3mm_D2.5mm_P10.16mm_Horizontal
RV1: 1K; Potentiometer_Trimmer_Vishay_T73XX_Vertical
U1, U4: 4N35; DIP-6_W7.62mm
U2: 7905; TO-220-3_Vertical
U3: IRS2092; SOIC-16_3.9x9.9mm_Pitch1.27mm
U5: 6N136; DIP-8_W7.62mm
U6: 7805; TO-220-3_Vertical
U7: LM7812; TO-220-3_Vertical

Connections:
GND: C2.1, C4.2, C7.2, C8.2, C10.2, C11.2, C12.1, C15.2, C18.2, C19.2, C21.2, C22.2, C23.1, C28.2, C29.2, C30.1, D2.1 (K), D5.2 (A), J1.1, J2.1, J8.1, J9.1, Q4.2 (C), R4.2, R5.2, R24.2, R27.2, U1.2, U2.1 (GND), U3.2 (GND), U6.2 (GND)
unnamed: C1.1, C10.1, C11.1, Q1.3 (S), R10.2, U3.1 (VAA)
unnamed: C1.2, C2.2, C4.1, C9.2, D1.1 (K), R1.2, U3.6 (VSS), U4.4
unnamed: C3.1, J6.1, RV1.3
unnamed: C3.2, R3.2
unnamed: C5.1, R3.1, R11.2, U3.3 (IN-)
unnamed: C5.2, C6.1, R4.1
unnamed: C6.2, C7.1, U3.4 (COMP)
unnamed: C8.1, J11.1, R1.1, R5.1, U2.3 (VO)
unnamed: C9.1, J10.1, Q1.2 (G), R12.2, U3.5 (CSD)
unnamed: C12.2, D2.2 (A), R13.1, U2.2 (VI)
unnamed: C13.1, D3.1 (K), R18.2, U3.15 (VB)
unnamed: C13.2, J15.1, L1.1, Q2.3 (S), Q3.2 (D), R17.2, R28.2, U3.13 (VS)
unnamed: C14.1, R9.1, R14.2, U3.12 (VCC)
unnamed: C14.2, C16.2, C17.1, C20.2, C22.1, C23.2, C24.2, C25.2, C26.2, D1.2 (A), D6.2 (A), D8.2 (A), J9.2, Q3.3 (S), R6.2, R13.2, R15.1, R25.2, U3.10 (COM), U7.2 (GND)
unnamed: C15.1, J12.1, R10.1, U6.3 (VO)
unnamed: C16.1, C17.2, J14.1, R14.1, R16.1, U7.3 (VO)
unnamed: C18.1, D5.1 (K), R23.1, U6.1 (VI)
unnamed: C19.1, C21.1, C24.1, C25.1, C27.1, D4.1 (K), D7.1 (K), J1.2, Q2.2 (D), R18.1, R23.2
unnamed: C20.1, Q4.3 (E), U7.1 (VI)
unnamed: C26.1, D6.1 (K), Q4.1 (B), R24.1
unnamed: C27.2, R25.1
unnamed: C28.1, D7.2 (A), D8.1 (K), J7.1, J8.2, L1.2, R26.1, R27.1
unnamed: C29.1, R26.2
unnamed: C30.2, R11.1, R28.1
unnamed: D3.2 (A), R16.2
unnamed: D4.2 (A), R19.1, R20.1
unnamed: J2.2, RV1.2
unnamed: J3.1, U1.4
unnamed: J3.2, U1.5
unnamed: J4.1, U4.2
unnamed: J4.2, R8.2
unnamed: J5.1, U5.5
unnamed: J5.2, U5.6, U5.8
unnamed: J13.1, R22.2, U3.11 (LO), U5.2
unnamed: Q1.1 (D), R2.2
unnamed: Q2.1 (G), R21.1
unnamed: Q3.1 (G), R22.1
unnamed: R2.1, U1.1
unnamed: R6.1, R7.2, U3.8 (OCSET)
unnamed: R7.1, U3.7 (VREF)
unnamed: R8.1, U4.1
unnamed: R9.2, U3.9 (DT)
unnamed: R12.1, U4.5
unnamed: R15.2, U5.3
unnamed: R17.1, R19.2, U3.16 (CSH)
unnamed: R20.2, R21.2, U3.14 (HO)

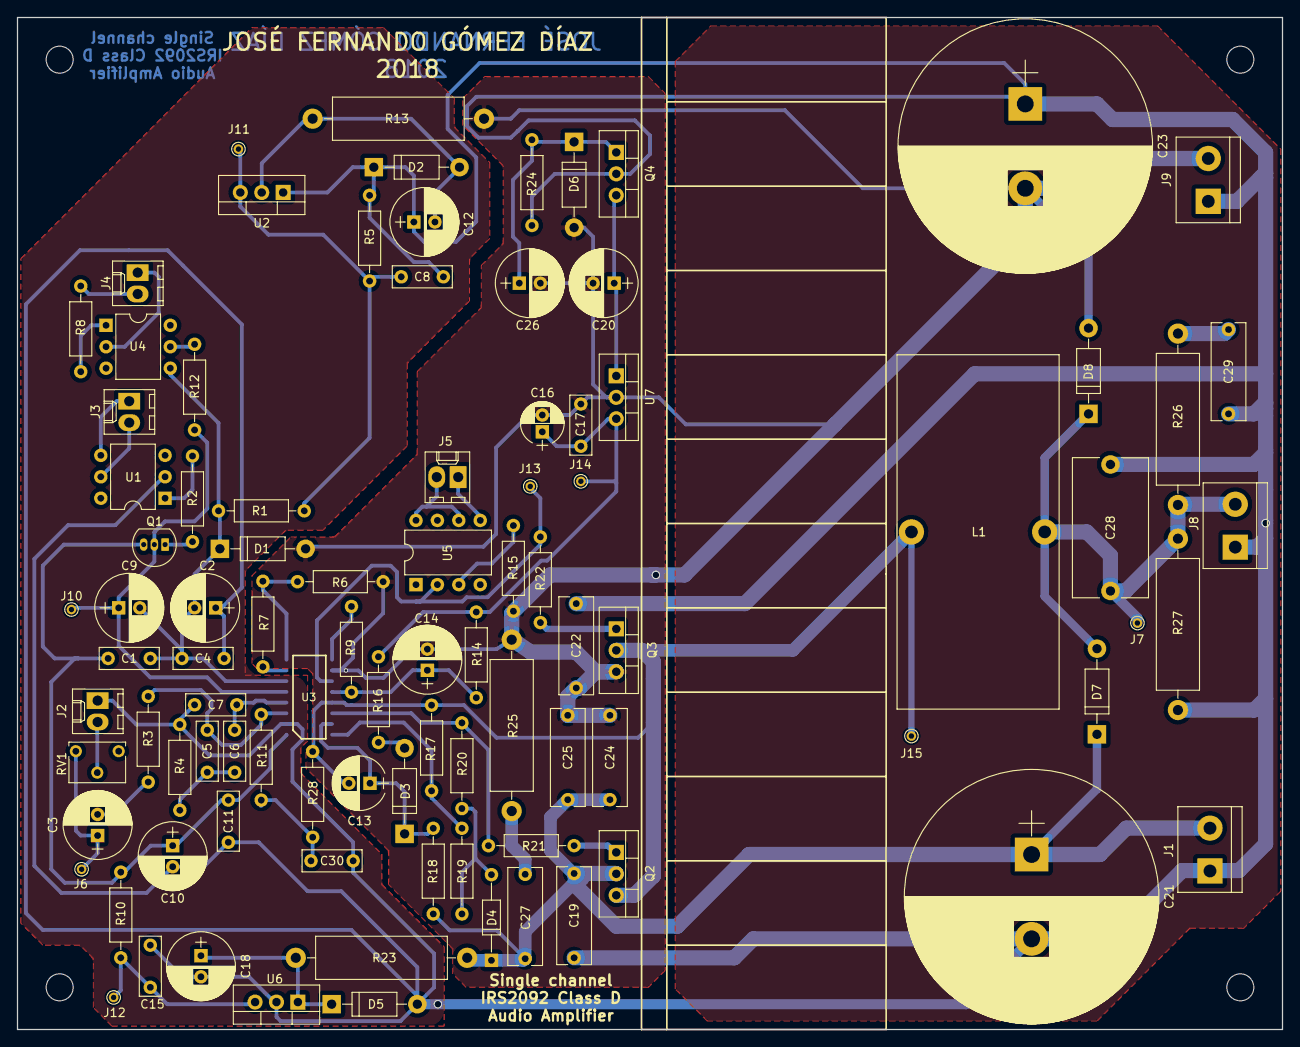
[picture p38: board IRS2092_board_H61M.kicad_pcb from above]

Board: 2 copper layers, 150.0 x 120.0 mm, 96 parts (1 on the bottom side), 47 nets.

Other parts of the board:
 : MountingHole_3.2mm_M3
 #2: MountingHole_3.2mm_M3
