josefe17/ClassDAmplifier/schematics-PCB/power_rectifier_board_510/power_rectifier_board_510.kicad_pcb

## KiCad design schematics-PCB/power_rectifier_board_510/power_rectifier_board_510.kicad_pcb (2018-05-30)

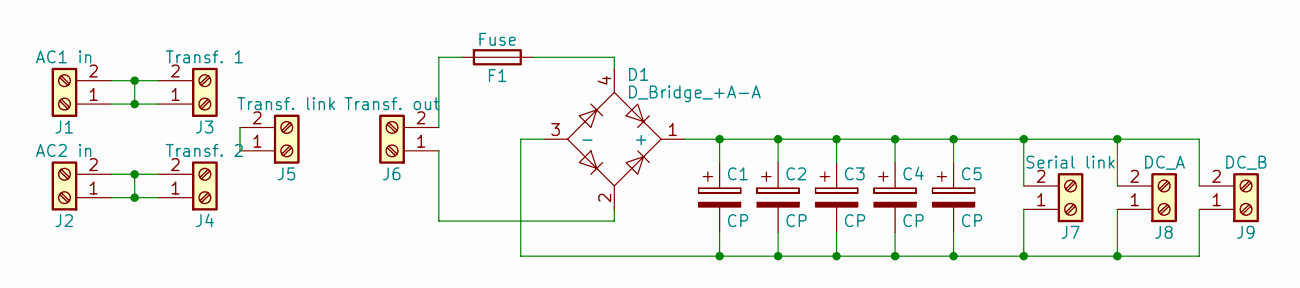
[picture p39: schematic power_rectifier_board_510.sch]

Parts:
C1, C2, C3: CP; CP_Radial_D30.0mm_P10.00mm_SnapIn
C4: CP; CP_Radial_D22.0mm_P10.00mm_SnapIn
C5: CP; CP_Radial_D18.0mm_P7.50mm
D1: D_Bridge_+A-A; bridge_kbpc_3506
F1: Fuse; Fuseholder5x20_horiz_open_universal_RSP
J1: AC1 in; TerminalBlock_bornier-2_P5.08mm
J2: AC2 in; TerminalBlock_bornier-2_P5.08mm
J3: Transf. 1; TerminalBlock_bornier-2_P5.08mm
J4: Transf. 2; TerminalBlock_bornier-2_P5.08mm
J5: Transf. link; TerminalBlock_bornier-2_P5.08mm
J6: Transf. out; TerminalBlock_bornier-2_P5.08mm
J7: Serial link; TerminalBlock_bornier-2_P5.08mm
J8: DC_A; TerminalBlock_bornier-2_P5.08mm
J9: DC_B; TerminalBlock_bornier-2_P5.08mm

Connections:
unnamed: C1.1, C2.1, C3.1, C4.1, C5.1, D1.1 (+), J7.2, J8.2, J9.2
unnamed: C1.2, C2.2, C3.2, C4.2, C5.2, D1.3 (-), J7.1, J8.1, J9.1
unnamed: D1.2, J6.1
unnamed: D1.4, F1.1
unnamed: F1.2, J6.2
unnamed: J1.1, J1.2, J3.1, J3.2
unnamed: J2.1, J2.2, J4.1, J4.2
unnamed: J5.1, J5.2

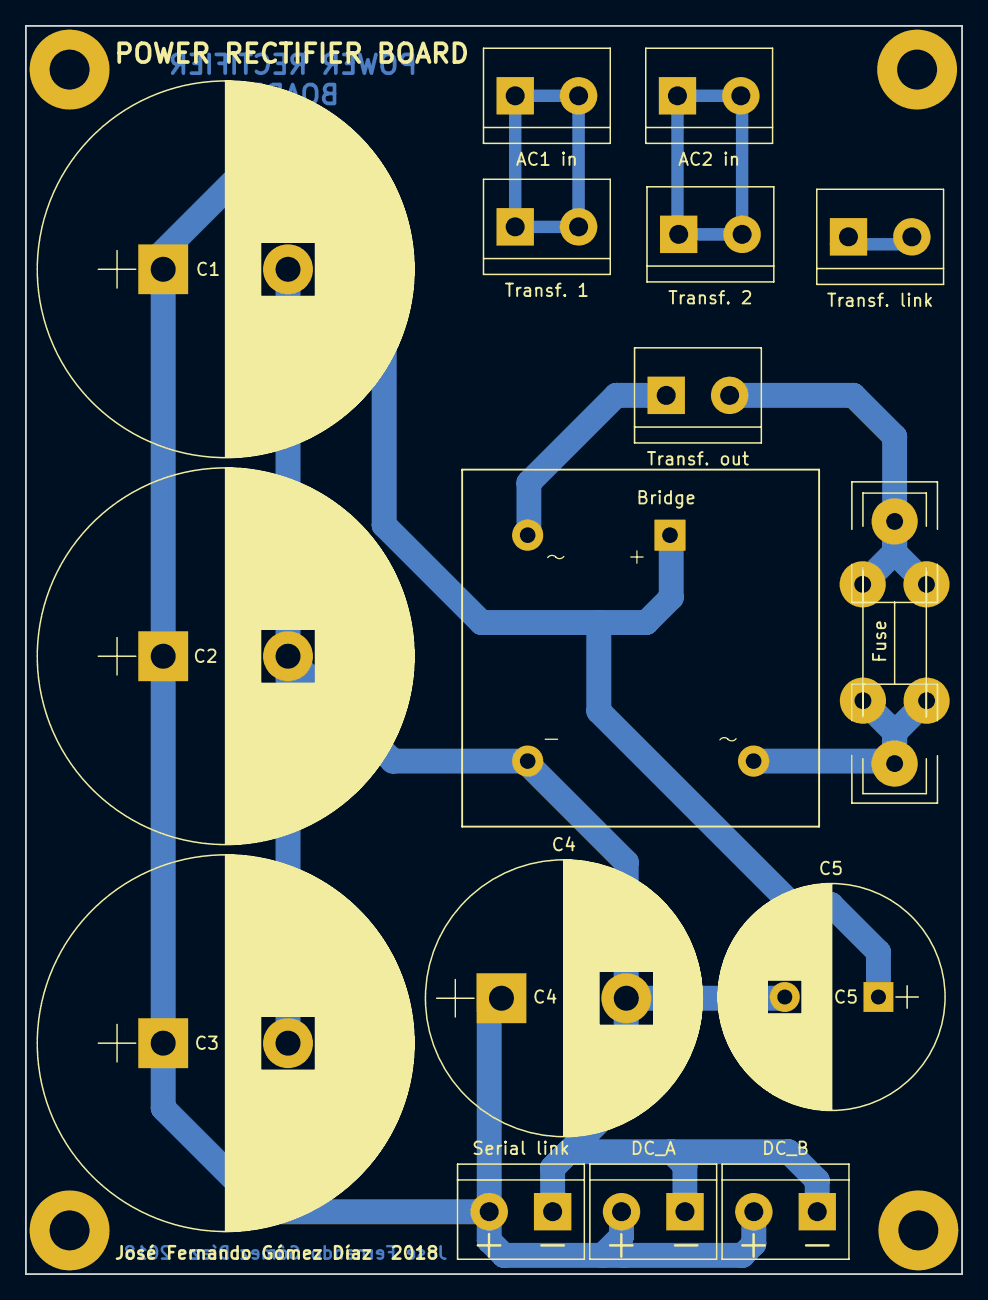
[picture p40: board power_rectifier_board_510.kicad_pcb from above]

Board: 2 copper layers, 75.0 x 100.0 mm, 17 parts (0 on the bottom side), 8 nets.

Other parts of the board:
 Ref**: MountingHole_3.2mm_M3_Pad
