josefe17/ClassDAmplifier/schematics-PCB/preamplifier_510/preamplifier_510.kicad_pcb

## KiCad design schematics-PCB/preamplifier_510/preamplifier_510.kicad_pcb (2018-05-30)

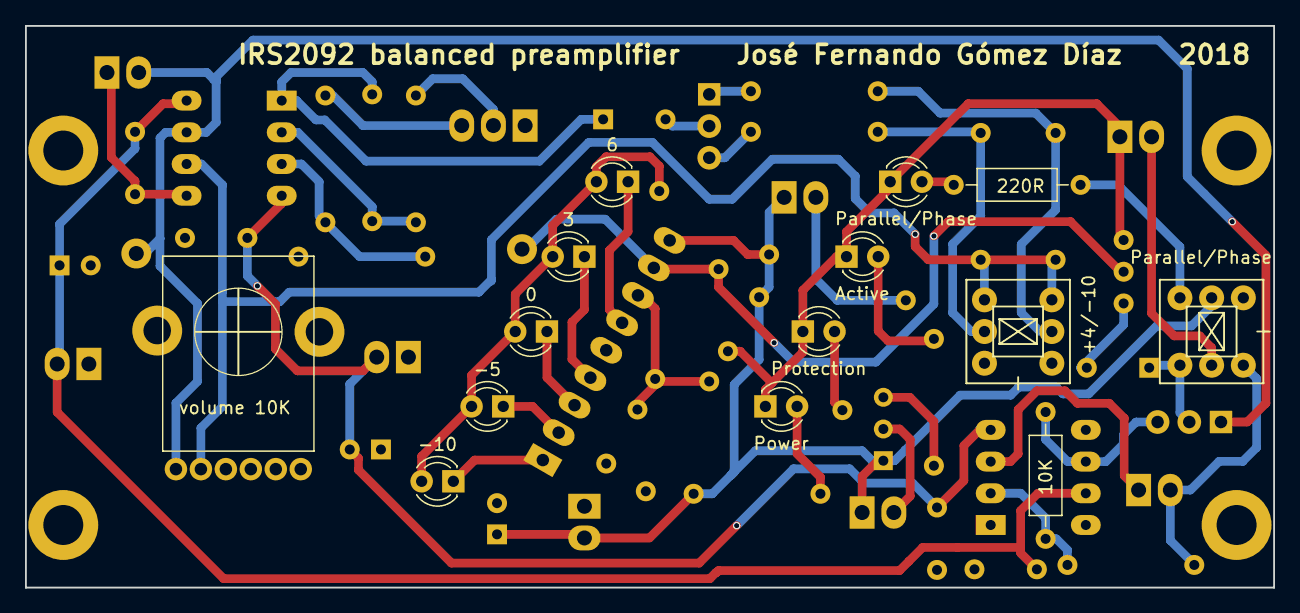
[picture p41: board preamplifier_510.kicad_pcb from above]

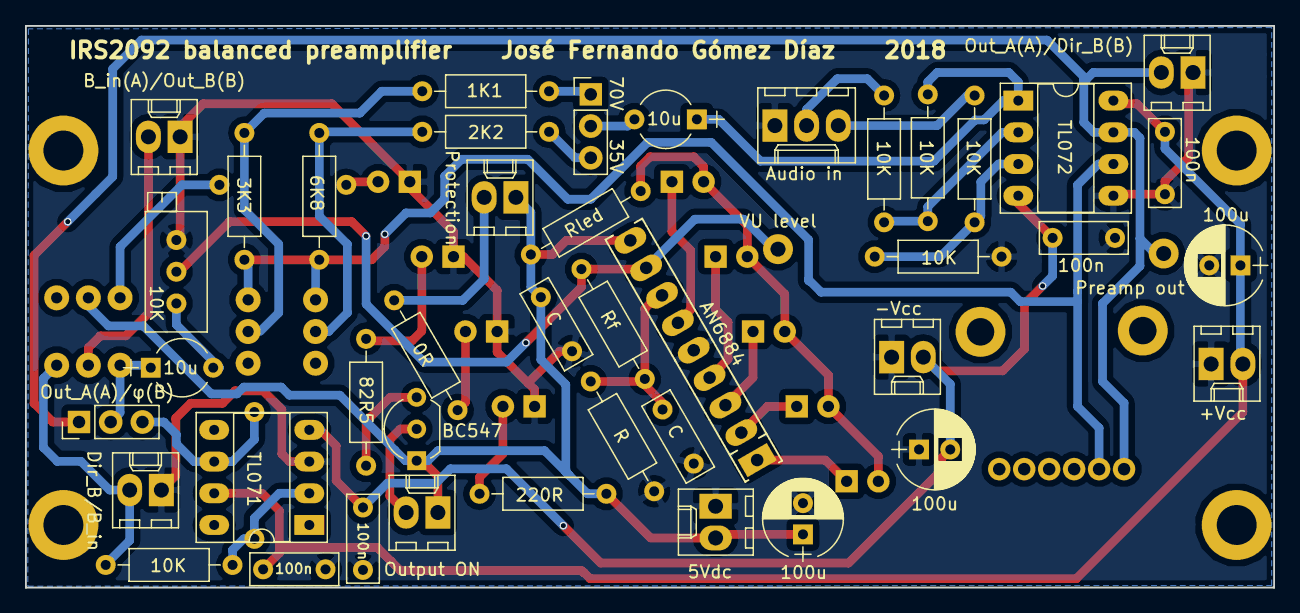
[picture p42: board preamplifier_510.kicad_pcb from below]

Board: 2 copper layers, 100.0 x 45.0 mm, 58 parts (44 on the bottom side), 38 nets.

Parts:
C1, C8, C9: 100u; CP_Radial_D6.3mm_P2.50mm
C3, C6: 10u; CP_Radial_Tantal_D4.5mm_P5.00mm
C4, C7: C; C_Rect_L7.0mm_W2.5mm_P5.00mm
C10, C11, C12, C13: 100n; C_Rect_L7.0mm_W2.5mm_P5.00mm
D1: Power; LED_D3.0mm
D2: Parallel/Phase; LED_D3.0mm
D3: Active; LED_D3.0mm
D4: Protection; LED_D3.0mm
D5: -10; LED_D3.0mm
D6: -5; LED_D3.0mm
D7: 0; LED_D3.0mm
D8: 3; LED_D3.0mm
D9: 6; LED_D3.0mm
J1: 5Vdc; Molex_KK-6410-02_02x2.54mm_Straight
J2: Audio in; Molex_KK-6410-03_03x2.54mm_Straight
J4: Output ON; Molex_KK-6410-02_02x2.54mm_Straight
J5: Protection; Molex_KK-6410-02_02x2.54mm_Straight
J6: -Vcc; Molex_KK-6410-02_02x2.54mm_Straight
J7: +Vcc; Molex_KK-6410-02_02x2.54mm_Straight
J8: Out_A(A)/Dir_B(B); Molex_KK-6410-02_02x2.54mm_Straight
J9: Dir_B/B_in; Molex_KK-6410-02_02x2.54mm_Straight
J10: B_in(A)/Out_B(B); Molex_KK-6410-02_02x2.54mm_Straight
J11: VU level; PINTST
J12: Preamp out; PINTST
JP1: 70V 35V; Pin_Header_Straight_1x03_Pitch2.54mm
JP2: Out_A(A)/φ(B); Pin_Header_Straight_1x03_Pitch2.54mm
Q1: BC547; TO-92_Inline_Wide
R1, R2: 220R; R_Axial_DIN0207_L6.3mm_D2.5mm_P10.16mm_Horizontal
R3, R4, R6, R7, R15, R16: 10K; R_Axial_DIN0207_L6.3mm_D2.5mm_P10.16mm_Horizontal
R5: 82R5; R_Axial_DIN0207_L6.3mm_D2.5mm_P10.16mm_Horizontal
R8: 0R; R_Axial_DIN0207_L6.3mm_D2.5mm_P10.16mm_Horizontal
R9: 1K1; R_Axial_DIN0207_L6.3mm_D2.5mm_P10.16mm_Horizontal
R10: 2K2; R_Axial_DIN0207_L6.3mm_D2.5mm_P10.16mm_Horizontal
R11: R; R_Axial_DIN0207_L6.3mm_D2.5mm_P10.16mm_Horizontal
R12: 3K3; R_Axial_DIN0207_L6.3mm_D2.5mm_P10.16mm_Horizontal
R13: 6K8; R_Axial_DIN0207_L6.3mm_D2.5mm_P10.16mm_Horizontal
R14: Rled; R_Axial_DIN0207_L6.3mm_D2.5mm_P10.16mm_Horizontal
R17: Rf; R_Axial_DIN0207_L6.3mm_D2.5mm_P10.16mm_Horizontal
RV1: volume 10K; Potentiometer_Alps_RK12L_Horizontal
RV2: 10K; Potentiometer_Trimmer_Bourns_3296X
SW1: Parallel/Phase; DPDT_Pushbutton
SW2: +4/-10; DPDT_Pushbutton
U1: TL072; DIP-8_W7.62mm_Socket_LongPads
U2: AN6884; SIP9_Housing_BigPads
U3: TL071; DIP-8_W7.62mm_Socket_LongPads

Connections:
GND: C1.2, C4.2, C7.2, C8.1, C9.2, C10.1, C11.2, C12.1, C13.2, D1.1, D2.1, D3.1, D4.1, J1.1, J2.1, J6.1, J7.1, J8.1, J9.1, J10.1, R6.2, R11.2, RV2.3, U1.5, U2.5, U3.3
unnamed: C1.1, C4.1, J1.2, J4.1, J5.1, Q1.1, R1.1, R14.2, SW1.2, U2.9
unnamed: C3.1, R7.1, U1.1
unnamed: C3.2, JP1.2
unnamed: C6.1, JP2.2, SW1.6
unnamed: C6.2, RV2.1
unnamed: C7.1, R11.1, R17.2, U2.7
unnamed: C8.2, C10.2, C12.2, J6.2, U1.4, U3.4
unnamed: C9.1, C11.1, C13.1, J7.2, U1.8, U3.7
unnamed: D1.2, R1.2
unnamed: D2.2, R2.2
unnamed: D3.2, R5.2
unnamed: D4.2, R8.2
unnamed: D5.1, U2.1
unnamed: D5.2, D6.2, D7.2, D8.2, D9.2, R14.1
unnamed: D6.1, U2.2
unnamed: D7.1, U2.3
unnamed: D8.1, U2.4
unnamed: D9.1, U2.6
unnamed: J2.2, R3.2
unnamed: J2.3, R4.2
unnamed: J4.2, Q1.2
unnamed: J5.2, R8.1
unnamed: J9.2, R15.2, SW1.4
unnamed: J10.2, SW1.5
unnamed: J11.1, R17.1, RV2.2, U2.8
unnamed: J8.2, J12.1, JP2.1, RV1.3, U1.7
unnamed: JP1.1, R9.2
unnamed: JP1.3, R10.2
unnamed: JP2.3, R16.1, U3.6
unnamed: Q1.3, R5.1
unnamed: R2.1, SW1.3
unnamed: R3.1, R7.2, U1.2
unnamed: R4.1, R6.1, U1.3
unnamed: R10.1, R13.2, SW2.5
unnamed: R12.1, R13.1, RV1.1, SW2.3, SW2.6, U1.6
unnamed: R9.1, R12.2, SW2.2
unnamed: R15.1, R16.2, U3.2
