josefe17/ClassDAmplifier/schematics-PCB/regulated_power_supply_510/regulated_power_supply_510.kicad_pcb

## KiCad design schematics-PCB/regulated_power_supply_510/regulated_power_supply_510.kicad_pcb (2018-05-30)

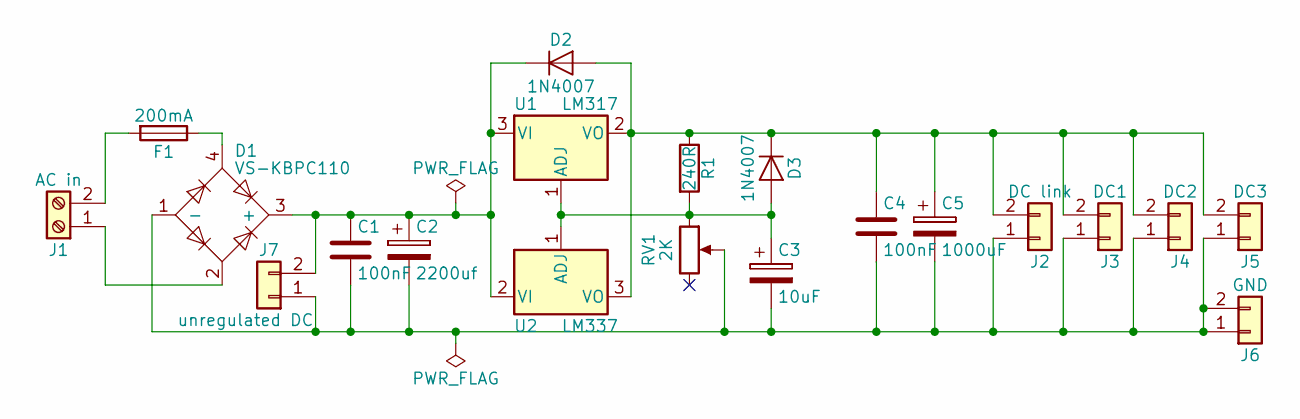
[picture p43: schematic regulated_power_supply_510.sch]

Parts:
C1, C4: 100nF; C_Rect_L7.0mm_W2.5mm_P5.00mm
C2: 2200uf; CP_Radial_D18.0mm_P7.50mm
C3: 10uF; CP_Radial_D8.0mm_P2.50mm
C5: 1000uF; CP_Radial_D18.0mm_P7.50mm
D1: VS-KBPC110; Diode_Bridge_15.7x15.7
D2, D3: 1N4007; D_DO-41_SOD81_P10.16mm_Horizontal
F1: 200mA; Fuseholder5x20_horiz_open_universal_RSP
J1: AC in; TerminalBlock_bornier-2_P5.08mm
J2: DC link; Molex_KK-6410-02_02x2.54mm_Straight
J3: DC1; Molex_KK-6410-02_02x2.54mm_Straight
J4: DC2; Molex_KK-6410-02_02x2.54mm_Straight
J5: DC3; Molex_KK-6410-02_02x2.54mm_Straight
J6: GND; Molex_KK-6410-02_02x2.54mm_Straight
J7: unregulated DC; Molex_KK-6410-02_02x2.54mm_Straight
R1: 240R; R_Axial_DIN0207_L6.3mm_D2.5mm_P10.16mm_Horizontal
RV1: 2K; Potentiometer_Trimmer_Vishay_T73XX_Vertical
U1: LM317; TO-220-3_Vertical
U2: LM337; TO-220-3_Vertical

Connections:
unnamed: C1.1, C2.1, D1.3 (+), D2.1 (K), J7.2, U1.3 (VI), U2.2 (VI)
unnamed: C1.2, C2.2, C3.2, C4.2, C5.2, D1.1 (-), J2.1, J3.1, J4.1, J5.1, J6.1, J6.2, J7.1, RV1.2
unnamed: C3.1, D3.2 (A), R1.2, RV1.1, U1.1 (ADJ), U2.1 (ADJ)
unnamed: C4.1, C5.1, D2.2 (A), D3.1 (K), J2.2, J3.2, J4.2, J5.2, R1.1, U1.2 (VO), U2.3 (VO)
unnamed: D1.2, J1.1
unnamed: D1.4, F1.1
unnamed: F1.2, J1.2

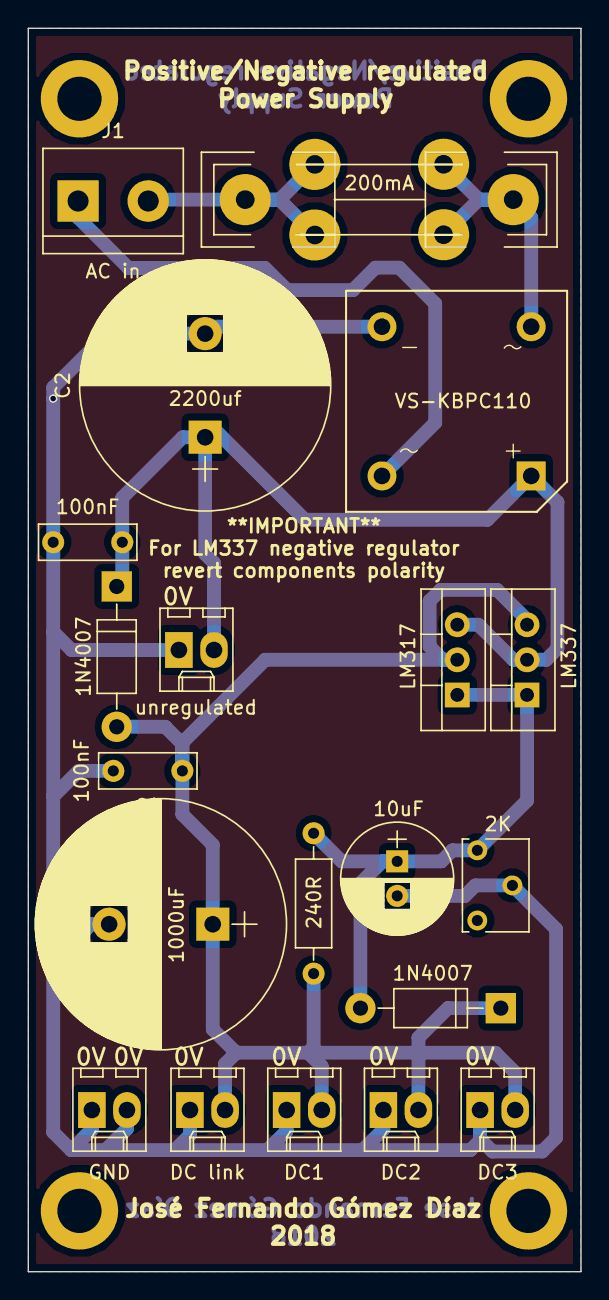
[picture p44: board regulated_power_supply_510.kicad_pcb from above]

Board: 2 copper layers, 40.0 x 90.0 mm, 20 parts (0 on the bottom side), 7 nets.
